banpot/LightCheck-KM/hardware/enclosure/README.md

# กล่องเครื่องวัดแสง LightCheck KM (ไฟล์พิมพ์ 3 มิติ)

LightCheck KM enclosure

กล่องสองชิ้น (ฐาน + ฝา) สำหรับ TSL2591 + Wemos D1 mini + LCD1602 I2C
ขนาดภายนอก **108 × 63 × 26 มม.** ใช้ถือวัดหรือตั้งบนขาตั้งกล้องที่ระดับระนาบวัด 75 ซม. ก็ได้

| ไฟล์ | รายละเอียด |
|---|---|
| `stl/lightcheck_base.stl` | ฐาน ชุดมาตรฐาน (วางพื้นกล่องลงฐานพิมพ์ จัดทิศไว้แล้ว) |
| `stl/lightcheck_lid.stl` | ฝา ชุดมาตรฐาน (คว่ำหน้าบนลงฐานพิมพ์ จัดทิศไว้แล้ว) |
| `stl/loose/lightcheck_base_loose.stl`, `stl/loose/lightcheck_lid_loose.stl` | ชุดหลวม สำหรับเครื่องพิมพ์ที่พิมพ์หยาบ (ดูหัวข้อถัดไป) |
| `stl/fit_test/hole_fit_test.stl` | แผ่นทดสอบรูสกรูและช่องนอต (~10 g) พิมพ์ก่อนเพื่อเลือกชุดที่พอดีกับเครื่อง |
| `src/lightcheck_enclosure.py` | สคริปต์สร้างแบบแบบ parametric (manifold3d) แก้ค่าแล้วรันใหม่ได้ |
| `stl/proxies/*.stl`, `stl/scene.json` | ชิ้นจำลองโมดูล ใช้ตรวจการชนและเรนเดอร์ภาพเท่านั้น (ไม่ต้องพิมพ์) |
| `render/` | ตัวเรนเดอร์ภาพ (three.js + Playwright) |
| `renders/*.png` | ภาพประกอบ (ประกอบแล้ว / แยกชิ้น / วางบนฐานพิมพ์) |

## แนวคิดการออกแบบ

- **หัววัดอยู่ระดับเดียวกับผิวฝา** บอร์ด TSL2591 ฝังในร่องบนผิวฝาด้านไกลจากผู้ใช้ ผิวบอร์ดเสมอผิวฝา ตัวเซนเซอร์โผล่สูงกว่าผิวฝา 0.65 มม.
  ส่วนของกล่องไม่มีอะไรสูงเกินระนาบเซนเซอร์ (หัวสกรูจมอยู่ในรูเคาน์เตอร์บอร์ ขอบ LCD ต่ำกว่าผิวฝา 0.3 มม.) เซนเซอร์จึงรับแสงได้เต็มครึ่งทรงกลมโดยไม่มีขอบกล่องบัง
- **ผู้ใช้ไม่บังแสง** LCD อยู่ฝั่งผู้ใช้ เซนเซอร์อยู่อีกฝั่ง และใช้ขาตั้งกล้องได้ (มีนอตหกเหลี่ยม 1/4"-20 ฝังใต้กล่อง ตรงใต้เซนเซอร์พอดี) จึงวัดที่ระนาบ 75 ซม. ได้โดยไม่มีเงาผู้วัด
- **ประกอบซ้ำง่าย** ไม่ต้องใช้ support ใช้สกรูทั่วไป และแก้ขนาดทุกค่าได้จากตัวแปรด้านบนของสคริปต์

## เลือกไฟล์ให้เหมาะกับเครื่องพิมพ์ (เผื่อความคลาดเคลื่อน)

เครื่องพิมพ์ FDM มักพิมพ์รูเล็กกว่าแบบราว 0.2–0.4 มม. และผนังหนากว่าแบบเล็กน้อย
รูนำสกรูที่ "พอดีเกิน" จึงขันยาก ไฟล์จึงมี 2 ชุดที่ต่างกันเฉพาะขนาดรูและระยะเผื่อ

| ชุด | ใช้กับ | ไฟล์ |
|---|---|---|
| **มาตรฐาน** | เครื่องที่ปรับตั้งดีแล้ว หัวฉีด 0.4 มม. ชั้น 0.2 มม. | `stl/lightcheck_base.stl` + `stl/lightcheck_lid.stl` |
| **หลวม (loose)** | เครื่องที่พิมพ์หยาบเล็กน้อย ชั้น 0.28 มม. หรือเนื้อพลาสติกล้น (over-extrusion) | `stl/loose/lightcheck_base_loose.stl` + `stl/loose/lightcheck_lid_loose.stl` |

**ฐานและฝาต้องมาจากชุดเดียวกัน** (ชุดหลวมยาวกว่า 1 มม. ทางด้านกว้าง)

| ขนาดในแบบ (มม.) | รุ่นแรก | มาตรฐาน | หลวม |
|---|---|---|---|
| รูนำสกรู M3 ในเสาฐาน | 2.5 | 2.8 | 3.0 |
| รูทะลุสกรู M3 ที่ฝา | 3.4 | 3.6 | 3.8 |
| รูเคาน์เตอร์บอร์หัวสกรู M3 | 6.4 | 6.6 | 6.8 |
| รูนำสกรู M2.5 (เสา LCD, รูบอร์ด TSL2591) | 2.1 | 2.3 | 2.5 |
| ช่องนอต 1/4"-20 (ปากกว้าง) | 11.46 | 11.66 | 11.86 |
| รูสกรูขาตั้งกล้อง | 6.8 | 7.0 | 7.2 |
| ระยะเผื่อขอบฝา และร่องบอร์ด TSL2591 (ต่อด้าน) | 0.30 | 0.35 | 0.55 |
| ระยะเผื่อช่องหน้าต่าง LCD (ต่อด้าน) | 0.40 | 0.45 | 0.65 |
| ลบมุมขอบล่างกัน elephant foot | 0.6 | 0.6 | 0.8 |
| ขนาดภายนอก | 108 × 63 × 26 | 108 × 63 × 26 | 108 × 64 × 26 |

ทุกรูนำสกรูมีปากผาย 45° ลึก 0.6 มม. ให้สกรูตั้งตรงและเริ่มกินเกลียวง่าย เสามุมขยายเป็น Ø7.6 มม.
เพื่อให้เนื้อพลาสติกรอบรูยังหนาพอ ระนาบเซนเซอร์ ตำแหน่งเซนเซอร์บนฝา และช่องรับแสงเหมือนเดิมทุกชุด

### ไม่แน่ใจว่าใช้ชุดไหน: พิมพ์แผ่นทดสอบก่อน

`stl/fit_test/hole_fit_test.stl` ใช้พลาสติกราว 10 กรัม มีเลขกำกับขนาดทุกรู (มม.)

- **รูนำ M3** 2.6 / 2.8 / 3.0 / 3.2 ในเสาสูง 6 มม. ขันสกรู M3 × 12 ด้วยไขควงมือ เลือกรูที่ขันได้โดยไม่ต้องออกแรงมากแต่สกรูไม่คลอน
  ได้ 2.8 ใช้ชุดมาตรฐาน ได้ 3.0 ใช้ชุดหลวม
- **รูนำ M2.5** 2.1 / 2.3 / 2.5 / 2.7 (2.3 = มาตรฐาน, 2.5 = หลวม)
- **ช่องนอต 1/4"** 11.46 / 11.66 / 11.86 เลือกช่องที่กดนอตลงด้วยนิ้วหรือเคาะเบา ๆ ได้
- ถ้าพอดีที่ 2.6 หรือ 3.2 ให้สร้างชุดของเครื่องตัวเอง โดย `--hole-comp` = ขนาดรู M3 ที่เลือก − 2.6

```bash
python3 src/lightcheck_enclosure.py --fit custom --hole-comp 0.6 --clr 0.6   # -> stl/custom/
```

### เคล็ดลับการขันสกรูลงพลาสติก

- ขันเข้าจนสุดแล้วคลายออกหนึ่งครั้งก่อนประกอบจริง เพื่อขึ้นเกลียวในพลาสติก
- ใช้ไขควงมือ ไม่ใช้สว่านไฟฟ้า (ความร้อนจากการหมุนเร็วทำให้ PLA ละลายและเกลียวรูด)
- ชิ้นรุ่นแรกที่พิมพ์ไปแล้วและรูคับ คว้านรูนำในเสาฐานด้วยดอกสว่าน 2.8 มม. (หมุนช้า ๆ) ก็ใช้ต่อได้

## การพิมพ์ (Print settings)

| รายการ | ค่าแนะนำ |
|---|---|
| วัสดุ | PLA หรือ PETG (PETG ทนความร้อนในรถ/ใกล้หน้าต่างกว่า) |
| Layer height | 0.2 มม. |
| Walls / perimeters | 3 |
| Top/bottom layers | 4–5 |
| Infill | 20% (gyroid/grid) |
| Support | **ไม่ต้องใช้** |
| ทิศการวาง | ฐาน: พื้นกล่องลงฐานพิมพ์ / ฝา: **คว่ำผิวบนลงฐานพิมพ์** (STL จัดทิศไว้แล้ว) |
| ปริมาตรเนื้อพลาสติก | ฐาน ~32 ซม.³, ฝา ~13 ซม.³ (รวมประมาณ 4–6 ชม. ที่ 0.2 มม. ขึ้นกับเครื่องพิมพ์) |

ส่วนที่เป็นสะพาน (bridge) มีแค่ เพดานร่องเซนเซอร์ (ช่วงสั้น 18.4 มม.) ช่อง USB (12.5 มม.) และบ่าเคาน์เตอร์บอร์ (6.4 มม.) ซึ่ง PLA/PETG ทั่วไปพิมพ์ได้
ขอบล่างของทั้งสองชิ้นลบมุม 0.6 มม. ไว้แล้ว เพื่อกลบ elephant foot

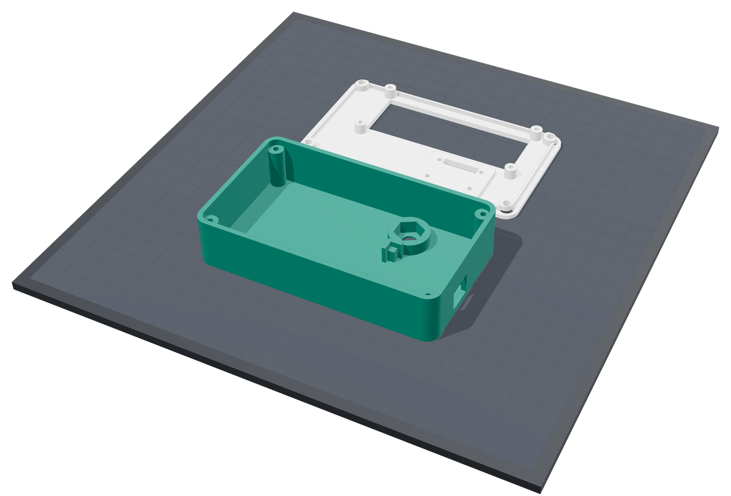
[picture p6: hardware/enclosure/renders/enclosure_printbed.png]
print bed


## อุปกรณ์ประกอบ (Hardware BOM)

| จำนวน | รายการ | ใช้ที่ |
|---|---|---|
| 4 | สกรู M3 × 12 มม. หัวกลม/หัวจม (self-tapping สำหรับพลาสติก) | ยึดฝากับฐาน (รูนำ Ø2.8 / Ø3.0 ในฐาน, รูเคาน์เตอร์บอร์ Ø6.6 / Ø6.8 ลึก 3 มม. ที่ฝา ตามชุดที่พิมพ์) |
| 4 | สกรู M2.5 × 6 มม. self-tapping | ยึด LCD1602 กับเสาใต้ฝา (รูนำ Ø2.3 / Ø2.5) |
| 1 | นอตหกเหลี่ยม 1/4"-20 UNC (ปากกว้าง 7/16" = 11.1 มม., หนา 7/32" = 5.6 มม.) | เกลียวขาตั้งกล้องใต้กล่อง |
| – | กาวร้อน / เทปกาวสองหน้าบาง | ยึด D1 mini กับแท่นรอง และยึด TSL2591 จากด้านใน |
| – | สายไฟ AWG 26–28 (บัดกรีตรง) | I2C: SDA, SCL, 3V3, 5V, GND |
| (เลือก) 4 | สกรู M2.5 × 4 มม. | ยึด TSL2591 จากด้านบน (หัวสกรูจะสูงกว่าระนาบเซนเซอร์ที่มุมบอร์ด ดูหมายเหตุ) |

## ขั้นตอนประกอบ

1. **D1 mini**: บัดกรีสายเข้าที่รู D1 (SCL), D2 (SDA), 3V3, 5V, G **จากด้านบนของบอร์ด** (ไม่ใส่ขา header ด้านล่าง) แล้ววางลงแท่นรองในฐาน ให้ขอบฝั่ง USB ชิดผนังขวา หยอดกาวร้อนเล็กน้อยที่มุม
2. **นอตขาตั้งกล้อง**: กดนอต 1/4"-20 ลงหลุมหกเหลี่ยมจากด้านในกล่อง (ด้านในเป็นบ่ารับ นอตจึงไม่หลุดเวลาขันขาตั้ง) จะหยอดกาวกันหมุนด้วยก็ได้
3. **LCD1602**: งอขา I2C 4 ขาของ backpack ลง 90° หรือบัดกรีสายตรง (ถ้าใช้ Dupont ตรง ต้องเพิ่ม `LCD_HEADER_CLEAR` เป็นประมาณ 25 มม.) ปรับ contrast ที่ trimpot ก่อนปิดฝา แล้วยึด LCD กับเสา 4 ต้นใต้ฝาด้วย M2.5 ให้กรอบโลหะสอดผ่านช่องหน้าต่าง
4. **TSL2591**: สอดสาย/ขา header ลงช่องใต้ร่อง วางบอร์ดลงร่องให้ผิวบอร์ดเสมอผิวฝา แล้วยึดจากด้านในด้วยกาวร้อนหรือเทป
   *แนะนำ:* ตัด jumper LED ของ Adafruit (ไฟเขียวบนบอร์ด) เพื่อไม่ให้มีแสงรบกวนตอนวัดแสงน้อย
5. ต่อสายตามผังวงจรใน `docs/wiring.md` แล้วทดสอบเปิดเครื่อง (ต้องขึ้น "All systems GO") **ก่อน**ปิดฝา
6. ปิดฝาโดยให้ขอบ lip ลงในผนังฐาน แล้วขันสกรู M3 × 12 ทั้ง 4 มุม (ไม่ต้องแน่นมาก ไม่งั้นเกลียวในพลาสติกจะรูด)

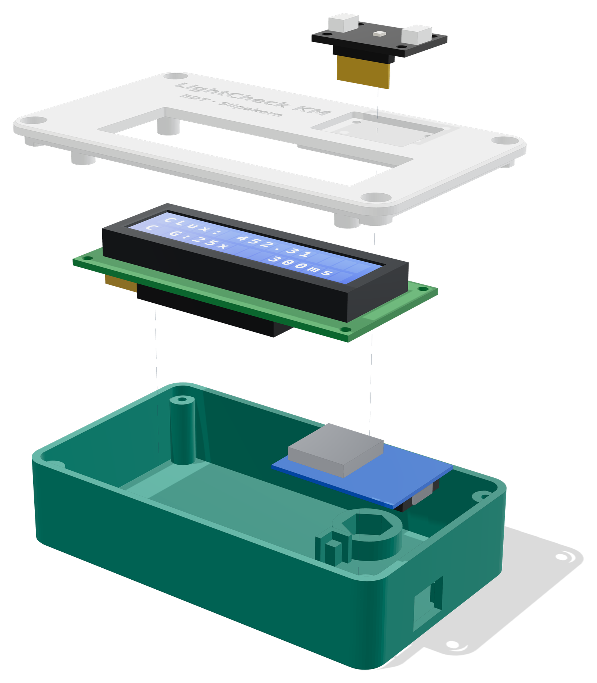
[picture p7: hardware/enclosure/renders/enclosure_exploded.png]
exploded


## ขนาดที่ต้องวัดจากโมดูลจริงก่อนพิมพ์ ([VERIFY])

ทุกค่าอยู่ในหัวไฟล์ `src/lightcheck_enclosure.py` โมดูลจากต่างร้านมีขนาดต่างกันได้

| ตัวแปร | ค่าที่ใช้ | ที่มา / หมายเหตุ |
|---|---|---|
| `TSL_W × TSL_D` | 25.4 × 17.78 มม. | จากไฟล์ EAGLE ของ Adafruit (#1980 รุ่น STEMMA QT); รุ่นเก่าที่ไม่มี STEMMA เล็กกว่า (~19 × 16 มม.) |
| `TSL_HOLE_DX/DY`, `TSL_HDR_Y` | 20.32 / 12.70 / −6.35 มม. | จากไฟล์ EAGLE ของ Adafruit (รู Ø2.5 ที่มุม, header 6 ขาตามขอบยาว, เซนเซอร์อยู่กลางบอร์ด) |
| `TSL_T` | 1.6 มม. | ความหนา PCB ซึ่งกำหนดความลึกร่องให้ผิวบอร์ดเสมอฝา |
| `LCD_BEZEL_H` | 7.0 มม. | ความสูงกรอบโลหะจากผิว PCB (ทั่วไป 6.5–9.5) ค่านี้กำหนดความยาวเสา LCD |
| `LCD_BEZEL_W × D`, offset | 71.2 × 24.2 มม., (0,0) | ขนาดกรอบโลหะและระยะเยื้องจากศูนย์กลาง PCB |
| `LCD_HOLE_DX/DY` | 75 × 31 มม. | ระยะรูยึด LCD |
| `LCD_BACK_DEPTH` | 12 มม. | ความลึกของ backpack + trimpot ใต้ PCB ของ LCD |
| `D1_L × D1_W`, `D1_T` | 34.2 × 25.6, 1.0 มม. | ขนาด D1 mini (v3/v4); ช่อง USB 12.5 × 9.5 มม. ใช้ได้ทั้ง micro-USB และ USB-C ไม่ว่าคอนเนกเตอร์จะอยู่ด้านบนหรือล่างของบอร์ด |
| `NUT_AF`, `NUT_T` | 11.46 + ค่าเผื่อรู / 5.56 มม. | นอต 1/4"-20 ที่ซื้อจริง |
| `FIT_PROFILES` | มาตรฐาน: รู +0.2, เผื่อ 0.35 / หลวม: รู +0.4, เผื่อ 0.55 | ค่าเผื่อของเครื่องพิมพ์ ปรับเองได้ด้วย `--fit custom --hole-comp X --clr Y` |

ผลตรวจล่าสุดของสคริปต์: ทั้งสองชิ้นปิดสนิท (watertight) ไม่มีส่วนใดชนกับชิ้นจำลองโมดูล
ช่องว่าง backpack ถึงพื้น 3.1 มม., ช่องว่าง D1 shield ถึง PCB ของ LCD 5.2 มม., ผิวบอร์ด TSL2591 = ผิวฝา = 26.0 มม., ยอดเซนเซอร์ 26.65 มม.

## ⚠️ ข้อกำหนดด้านคุณภาพการวัด

ตาม KM ข้อ 9.1.12 **ถ้าเปลี่ยนกล่อง ฝา ร่อง/ช่องรับแสง แผ่น diffuser หรือตำแหน่งเซนเซอร์ ต้องทวนสอบ (verification) กับเครื่องอ้างอิงใหม่ และพิจารณาสร้างค่า coefficient ใหม่**
ต้องบันทึกเวอร์ชันกล่องที่ใช้ (ชื่อไฟล์ STL และ commit) ไว้คู่กับ `CAL_MODEL_VERSION` ในรายงาน calibration ด้วย
ชุดมาตรฐาน/หลวมต่างกันเฉพาะรูสกรูและระยะเผื่อ ระนาบและตำแหน่งเซนเซอร์บนฝาเหมือนกัน แต่ให้ระบุชุดที่ใช้ในรายงานด้วย

หมายเหตุ: ขั้วต่อ STEMMA QT สีขาวบนบอร์ด Adafruit สูงกว่าเซนเซอร์ประมาณ 2.3 มม. ที่ระยะ ±10 มม.
จึงบังแสงเฉพาะมุมตกกระทบที่เกิน ~76° ซึ่งมีน้ำหนักตาม cosine น้อยมาก ถ้าใช้สกรูยึดบอร์ดจากด้านบนก็มีผลแบบเดียวกัน
ทั้งหมดนี้รวมอยู่ใน calibration แล้ว **ถ้าเปลี่ยนวิธียึดหรือตัดขั้วต่อออก ให้ทวนสอบใหม่**

## สร้างไฟล์ใหม่ (Regenerate)

```bash
pip install manifold3d trimesh numpy matplotlib
python3 src/lightcheck_enclosure.py        # สร้าง STL ทั้งชุดมาตรฐาน ชุดหลวม และแผ่นทดสอบ + ตรวจ watertight / ระยะชน / ระนาบเซนเซอร์ แล้วแสดง PASS
# render (ไม่บังคับ)
cd render && npm i && cd .. && python3 -m http.server 8765 &
node render/render.mjs hero exploded print
```

---

### English summary

Two-part, support-free enclosure (108 × 63 × 26 mm) for TSL2591 + Wemos D1 mini + LCD1602/I2C.
The TSL2591 board sits flush in a pocket on the top face at the far end, so nothing of the enclosure rises above the sensor plane
(screw heads are counterbored and the LCD bezel sits 0.3 mm below the top). A captured 1/4"-20 nut under the sensor allows
tripod mounting at the 75 cm measurement plane. Print in PLA/PETG at 0.2 mm, 3 walls, 20 % infill, no supports: base floor-down, lid top-face-down
(STLs are pre-oriented). Two fit profiles: `stl/` (standard, holes +0.2 mm, 0.35 mm clearance) and `stl/loose/` (coarse printers,
holes +0.4 mm, 0.55 mm clearance); print `stl/fit_test/hole_fit_test.stl` (~10 g) to choose, or build your own with
`--fit custom --hole-comp X --clr Y`. Hardware: 4× M3×12 self-tapping, 4× M2.5×6 self-tapping, 1× 1/4"-20 hex nut. All `[VERIFY]` dimensions are named
parameters in `src/lightcheck_enclosure.py`. Any change to the enclosure, aperture or sensor position requires re-verifying the calibration (KM §9.1.12).
