banpot/LightCheck-KM/docs/references.md

# เอกสารอ้างอิง

ตรวจสอบการเข้าถึงลิงก์ ณ วันที่ 10 สิงหาคม 2569 (และ 23 ตุลาคม 2569 สำหรับ [4][5][7])

1. กรมการเปลี่ยนแปลงสภาพภูมิอากาศและสิ่งแวดล้อม. (2569). *เกณฑ์การประเมินสำนักงานสีเขียว (Green Office) ปี 2569*. https://www.dcce.go.th/15765/
2. กรมสวัสดิการและคุ้มครองแรงงาน. (2561). *ประกาศเรื่อง มาตรฐานความเข้มของแสงสว่าง (ตารางมาตรฐานแนบท้ายประกาศ)*. https://osh.labour.go.th/wp-content/uploads/2026/02/lighting-std-2561.pdf
3. กรมสวัสดิการและคุ้มครองแรงงาน. (2561). *หลักเกณฑ์ วิธีการตรวจวัด และการวิเคราะห์สภาวะการทำงานเกี่ยวกับระดับความร้อน แสงสว่าง หรือเสียง*. https://osh.labour.go.th/wp-content/uploads/2026/02/11.pdf
4. Adafruit Industries. *Adafruit TSL2591 High Dynamic Range Digital Light Sensor*. https://learn.adafruit.com/adafruit-tsl2591/overview
5. ams. (2018). *TSL2591 Light-to-Digital Converter Datasheet* DS000338 v2-04 (6-00). https://cdn-learn.adafruit.com/assets/assets/000/078/658/original/TSL2591_DS000338_6-00.pdf
6. Lorenzo, O. G., Suárez-García, A., Peña, D. G., Fuente, M. G., & Granados-López, D. (2022). A Low-Cost Luxometer Benchmark for Solar Illuminance Measurement System Based on the Internet of Things. *Sensors, 22*(19), 7107. https://doi.org/10.3390/s22197107
7. HIOKI. *LUX METER FT3424 – specifications* (linearity ±2 % rdg., JIS C 1609-1:2006 general AA, DIN 5032-7 class B). https://www.hioki.com/th-th/products/field-measuring/light-lux/id_5892
8. DigiKey Thailand. *Adafruit Industries 1980 (TSL2591 breakout)*. https://www.digikey.co.th/th/products/detail/adafruit-industries-llc/1980/4990786
9. Shopee Thailand. *Wemos D1 mini ESP8266* (ตัวอย่างราคาออนไลน์)
10. ArduinoAll / AllNewStep. *LCD1602 พร้อม I2C Interface 5V* (ตัวอย่างราคาออนไลน์)
11. Thai Interelectric. *HIOKI FT3424* (ตัวอย่างราคาในประเทศไทย). https://shop.thai-interelectric.co.th/shop/ft3424/
12. Adafruit. *Adafruit_TSL2591_Library* v1.4.5 (calculateLux, LUX_DF = 408). https://github.com/adafruit/Adafruit_TSL2591_Library
