banpot/LightCheck-KM/poster/LightCheck-KM_poster_80x100_editable.pptx

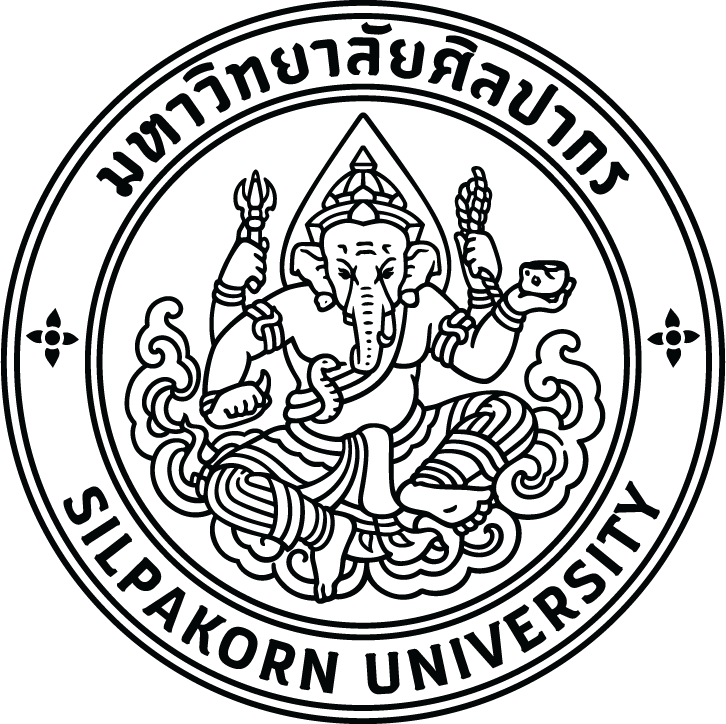
[picture p8: figure]

LightCheck KM

จากเครื่องวัดแสงต้นทุนต่ำ สู่ระบบความรู้
เพื่อยกระดับสภาพแวดล้อมสำนักงานสีเขียว

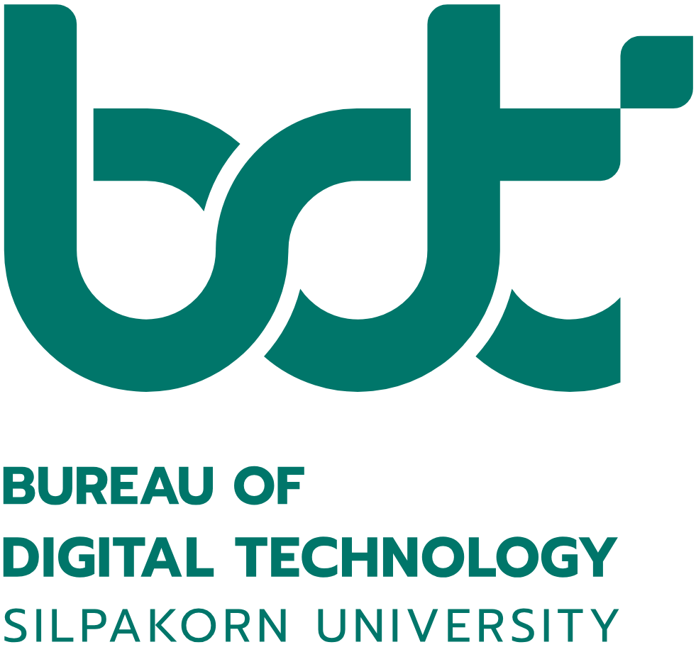
[picture p9: figure]
ภาพ bdt_logo_stacked.svg

KM · ด้านการบริหารจัดการและสร้างนวัตกรรม

INTRODUCTION

ที่มาและความสำคัญ

ว่าที่ ร.ต. ดร. บรรพต ดลวิทยากุล

ฝ่ายบริหารและพัฒนาดิจิทัลเทคโนโลยี สำนักดิจิทัลเทคโนโลยี มหาวิทยาลัยศิลปากร

METHODS

แนวคิดและกระบวนการดำเนินงาน

RESULTS

ผลลัพธ์จากการจัดการความรู้

“รู้สึกว่าพอ” อาจไม่พอ
สำหรับสายตาคนทำงานทั้งวัน

สายตาปรับตัวกับแสงสลัวจนเราไม่ทันสังเกต แต่ต้องเพ่งอยู่ตลอดวัน ผลเสียจึงสะสมกับคนทำงาน [8, 9]

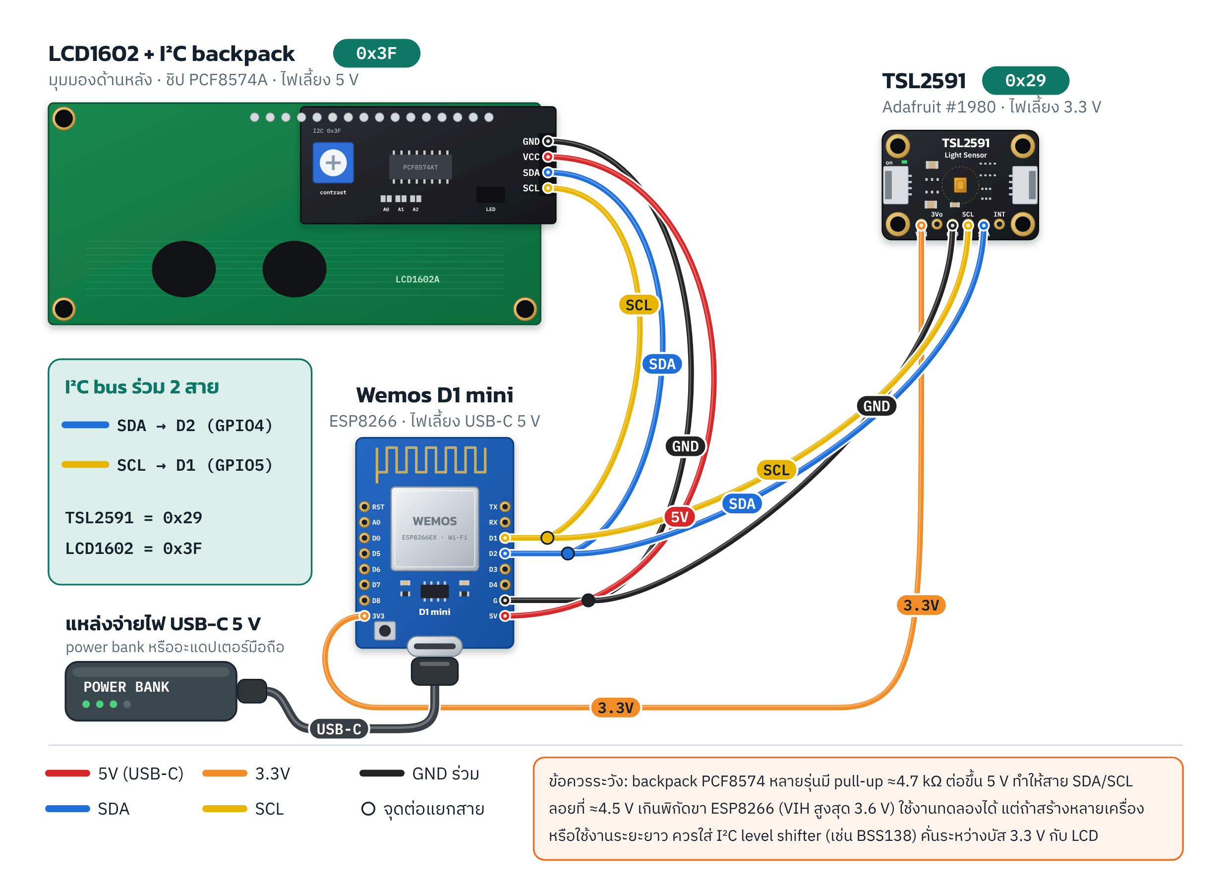
[picture p10: figure]
ภาพ wiring_diagram.svg

ภาพที่ 2 ผังวงจร: I²C ร่วม 2 สาย (SDA = D2, SCL = D1) · TSL2591 0x29 · LCD 0x3F · ไฟเลี้ยง USB-C 5 V จาก power bank

ยังไม่มีข้อมูลวัดคู่จริง จึงประเมินด้วยวิธีเชิงอัลกอริทึม: Monte Carlo 5,000 รอบ จาก datasheet TSL2591 + สเปก Hioki FT3424 (±2% rdg.) ผลจำลอง

±7.3%

ความคลาดเคลื่อน (95%) หลังชดเชย เทียบกับค่าจริง

37% → 2.5%

MAPE ก่อน → หลังชดเชย (P95 หลังชดเชย 4.0%)

ตัวชี้วัดจึงมีที่มา: Green Office 2569 ข้อ 5.2.1 ให้วัดเป็นตัวเลขทุกปีด้วยเครื่องที่สอบเทียบ ห้ามใช้แอปมือถือ [1] แต่เครื่องมาตรฐานที่ถูกสุด (HIOKI FT3424) ราคา 28,184 ฿ จึงมีได้ไม่กี่เครื่อง

เกณฑ์ขั้นต่ำเพื่อสายตาคนทำงาน [2] · วัดที่ระนาบ 75 ซม. ทุกช่อง 2×2 ม. และ ณ จุดทำงาน ในสภาพทำงานปกติ ช่วงแสงธรรมชาติน้อยที่สุด [3]

300 lx

ค่าเฉลี่ย
พื้นที่สำนักงาน

ตาล้า
ปวดตา

150 lx

จุดต่ำสุด
ของพื้นที่

ปวดศีรษะ
ไมเกรน

400–500

lux ณ จุดทำงาน
(งานเขียน พิมพ์ อ่าน)

ซึม
สมาธิลด

เสี่ยง
อุบัติเหตุ

45% → 0.07%

ตัดสินผ่าน/ไม่ผ่านผิดที่เกณฑ์ 300 lx (guard band: ส่งยืนยัน 13% ของจุด)

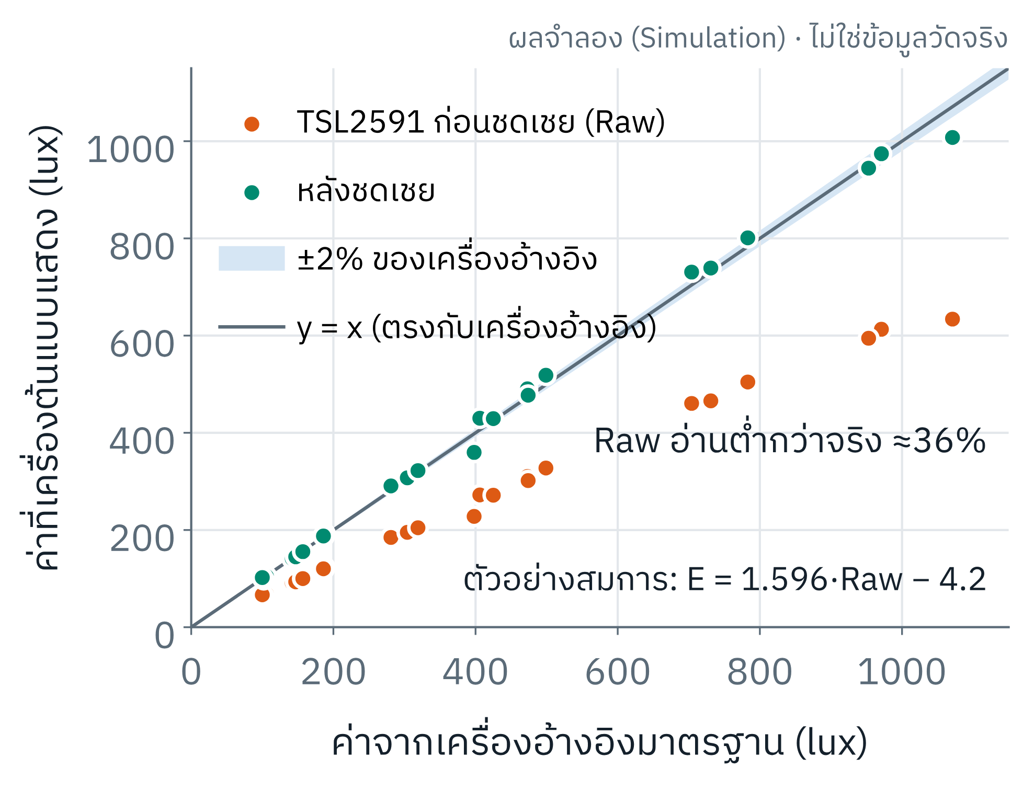
[picture p11: figure]
ภาพ fig_cal_scatter_poster.svg

ภาพที่ 6 ต้นแบบเทียบเครื่องอ้างอิง: ก่อนชดเชยอ่านต่ำกว่าจริงราว 1/3 (ประมาณจาก datasheet) หลังชดเชยเข้าใกล้ y = x

41 → 0

ระดับแสงที่ auto-range แกว่งจน SATURATED (v1.0 → v1.1, 521 ระดับ)

วัตถุประสงค์

ให้คนทำงานได้แสงที่เหมาะกับงานจริง ด้วยเครื่องคัดกรอง (pre‑survey) ต้นทุนต่ำที่ตรวจสอบย้อนกลับได้

กล่องพิมพ์ 3 มิติ (ไฟล์ STL เปิดให้ดาวน์โหลด)

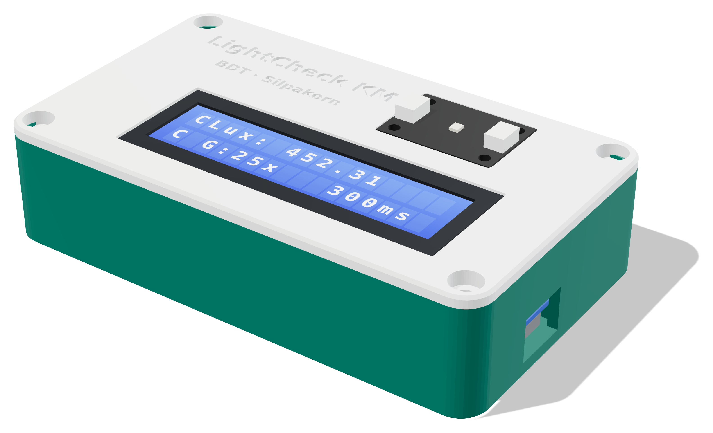
[picture p12: figure]

ภาพที่ 3 Render จากไฟล์ STL · 108×63×26 มม. · หัวรับแสงเสมอผิวฝา ไม่มีขอบบังแสง · ช่องนอต 1/4" ใต้กล่องสำหรับขาตั้งกล้องที่ระดับ 75 ซม.

1

2

3

เปลี่ยนความรู้ที่อยู่กับผู้พัฒนา ให้เป็นความรู้ขององค์กร: โค้ด SOP คู่มือ ไฟล์ STL ในคลังสาธารณะ

ปรับปรุงแสงด้วยข้อมูลเชิงประจักษ์ตามวงจร PDCA (ตรวจ → แก้ → ตรวจซ้ำ) ของ Green Office 5.2.1

วงจรการจัดการความรู้ (PDCA + KM)

ห้องทำงานเกือบทุกห้องของสำนักดิจิทัลเทคโนโลยี (ยกเว้นห้องประชุม) มีแสงต่ำกว่าระดับมาตรฐาน → ผู้บริหารวางแผนปรับปรุง

เช่น วัดได้ 270 lx: 18 W → 22 W

เช่น วัดได้ 220 lx, 6 ดวง → 9 ดวง

Lumen method: E = NΦ·UF·MF/A ⇒ E ∝ NΦ · เป้าหมาย = เกณฑ์ × (1 + U95) · ยืนยันด้วยเครื่องมาตรฐานก่อนจัดซื้อ

ผลการใช้งานจริง

10–30%

ขาดเล็กน้อย
เปลี่ยนหลอด LED
วัตต์สูงขึ้น

ขาดมาก
ติดหลอดไฟเพิ่ม

1

6

วางแผน

P · เกณฑ์ + จุดวัด

ใช้ซ้ำ

KM · public repo

LightCheck KM

PDCA + Tacit → Explicit

2

5

ตรวจวัด

D · pre-survey

ถอดบทเรียน

KM · บทเรียน

3

4

ตรวจสอบ

C · ยืนยันผล

ปรับปรุง

A · แก้ + ตรวจซ้ำ

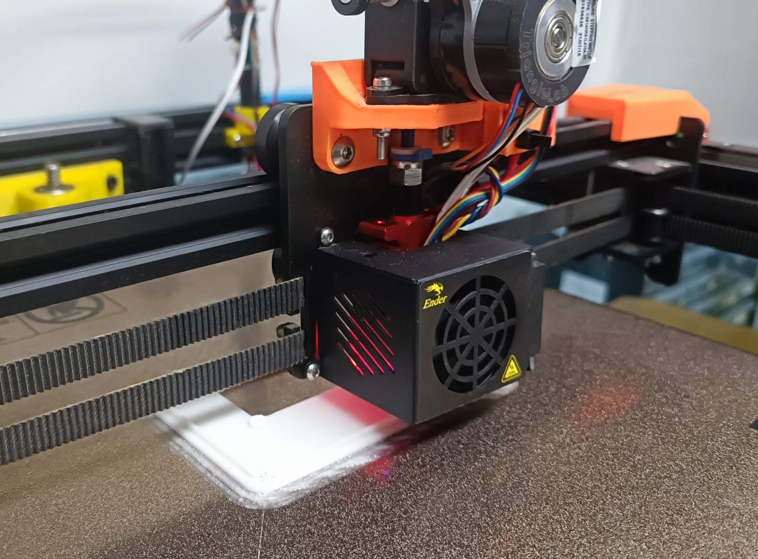
[picture p13: figure]
ภาพที่ 4 พิมพ์กล่อง Ender-6

ภาพที่ 4 พิมพ์ด้วย Creality Ender-6

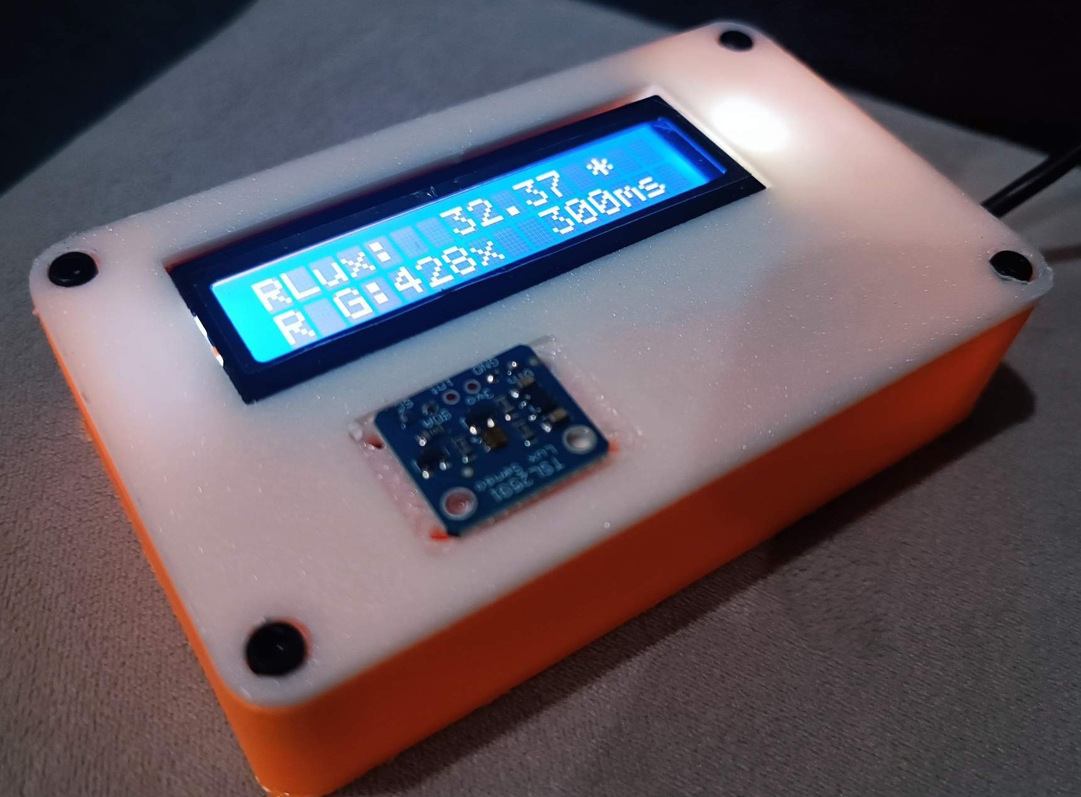
[picture p14: figure]
ภาพที่ 5 เครื่องที่ประกอบเสร็จ

ภาพที่ 5 เครื่องที่ประกอบเสร็จ พร้อมใช้

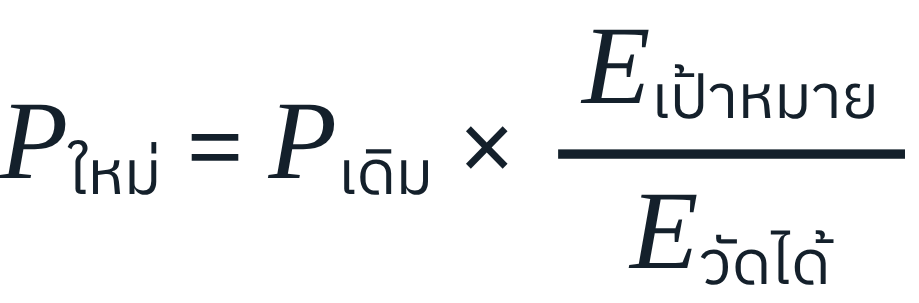
[picture p15: figure]
สูตรเปลี่ยนวัตต์หลอด
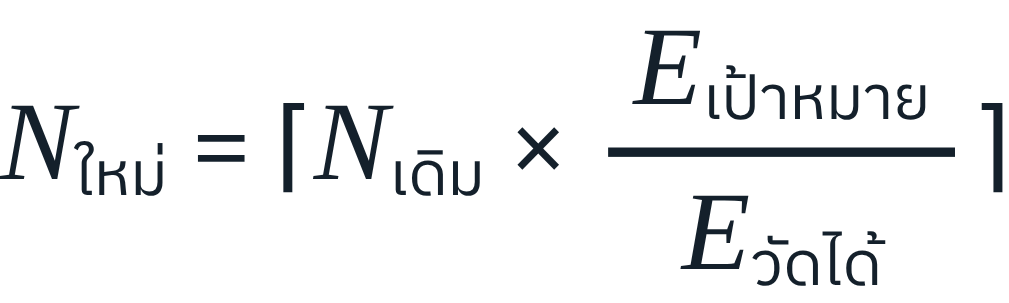
[picture p16: figure]
สูตรเพิ่มจำนวนหลอด

ภาพที่ 1 PDCA ของการดูแลแสง + ชั้น KM ทำให้ทุกรอบกลายเป็นความรู้ขององค์กร

อุปกรณ์และต้นทุน

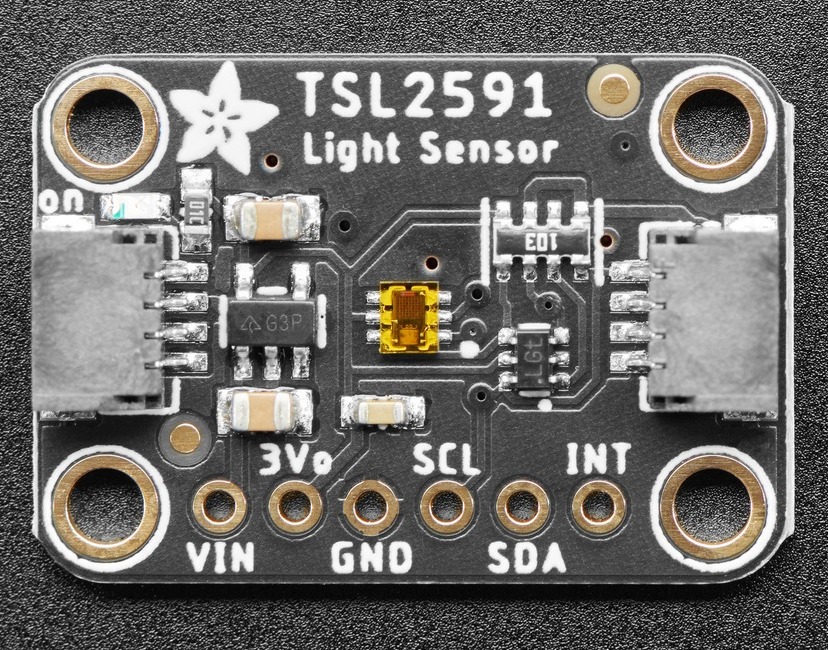
[picture p17: figure]
รูป TSL2591
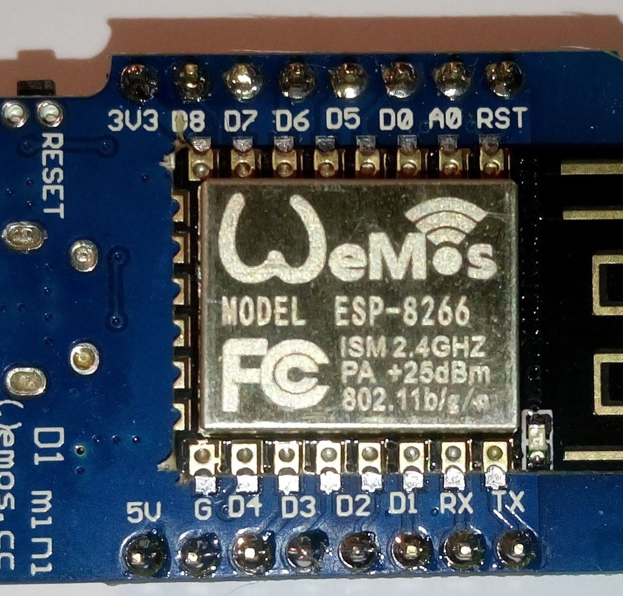
[picture p18: figure]
รูป Wemos D1 mini
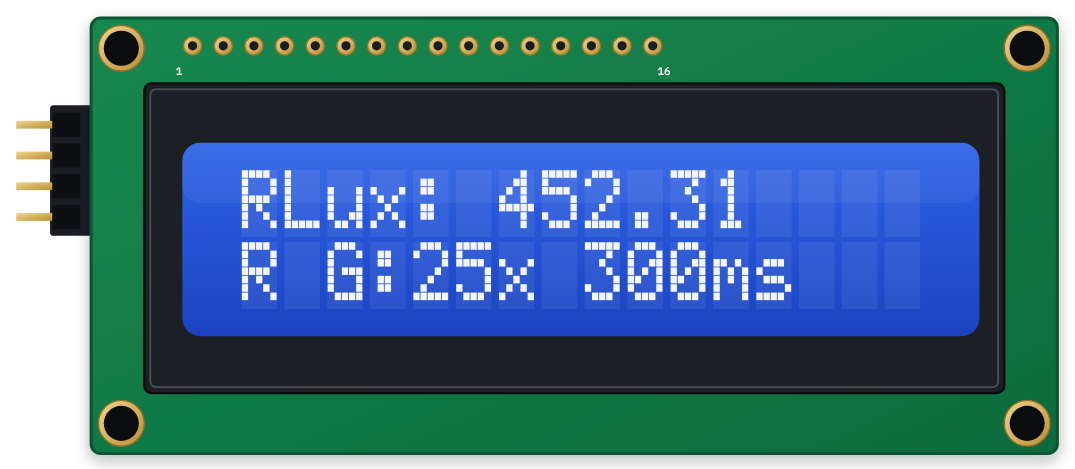
[picture p19: figure]
ภาพ component_lcd1602_front.svg

อัลกอริทึมใน firmware v1.1

Self-check I²C ก่อนวัด ป้องกันการบันทึกค่าจากระบบที่ต่อผิด

1

2

3

ตรวจ saturation ตาม datasheet (36,863 / 65,535 counts)

Auto-range มี hysteresis: 100–2,900 lx อ่านที่ gain 25× เสมอ

CONCLUSIONS

สรุปและบทเรียน

TSL2591

หัวรับแสง · 200 ฿

LightCheck KM
ต้นทุนจริง

HIOKI FT3424
ถูกที่สุดที่สำรวจได้

~73×

ภาพ: Adafruit Industries (CC BY-SA) · Tpkull / Wikimedia Commons (CC BY-SA 4.0)

≈ 385 ฿ (89 + 200 + 70 + PLA+ 54 g ≈ 26)

HIOKI FT3424 (ญี่ปุ่น, JIS C 1609-1 AA / DIN 5032-7 B) 26,340 ฿ + VAT 7% = 28,183.80 ฿ [7]

Wemos D1 mini

ESP8266 · 89 ฿

LCD1602 + I²C

จอแสดงผล · 70 ฿

28,184 ฿

4

5

บทเรียนหน้างาน: LED สว่างตามขนาดกระแส วูบ 100 ครั้ง/วินาทีจากไฟ 50 Hz [10] → integration 300 ms (30 รอบพอดี) + เฉลี่ย 5 ค่า

สมการชดเชยความคลาดเคลื่อน

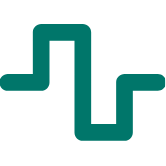
[picture p20: figure]
ภาพ #5

เฉลี่ย 5 รอบ ลดผล LED กะพริบ · จอแสดง * เมื่อค่านิ่ง (CV < 2%)

ชดเชย + traceability: บันทึก Raw/Corrected, gain และรุ่นสมการ

1.

2.

3.

เปิดให้ร่วมพัฒนาต่อบน GitHub

· วัดคู่จริงกับเครื่องมาตรฐาน

ใช้ได้จริง: เครื่องละ ~385 ฿ พบห้องแสงไม่พอ → แผนปรับปรุงทันที

บทเรียนหน้างาน: LED วูบ 100 ครั้ง/วินาทีตามไฟ 50 Hz → เฉลี่ย 5 ค่า ค่านิ่งขึ้น ~2.3 เท่า

ความรู้เป็นโค้ด SOP คู่มือ STL ที่ทำซ้ำได้โดยไม่ต้องพึ่งผู้พัฒนา

· สมการแยกตามชนิดหลอด

ถูกกว่า แต่ไม่ได้เทียบเท่า: ต้นแบบหลายเครื่อง = คัดกรองให้ทั่ว · เครื่องมาตรฐาน = ยืนยันผลทางการ

ใครใช้ประโยชน์ได้อย่างไร

คณะ / ส่วนงาน

เจ้าหน้าที่เทคนิค / นักวิจัย

ADC
CH0, CH1

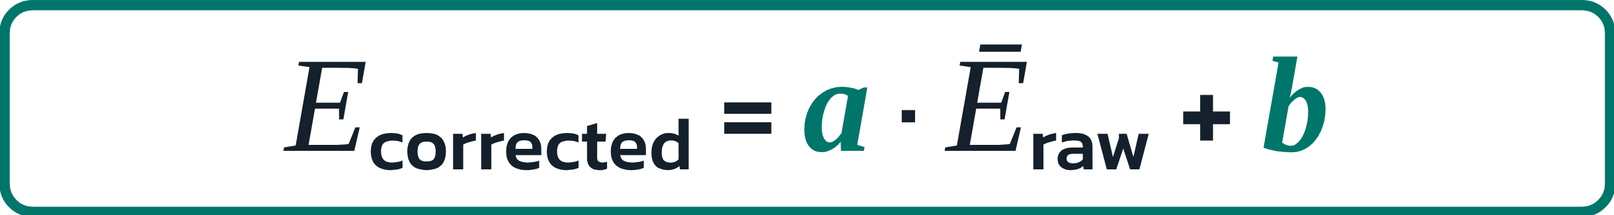
[picture p21: figure]
สมการชดเชย (หลัก)
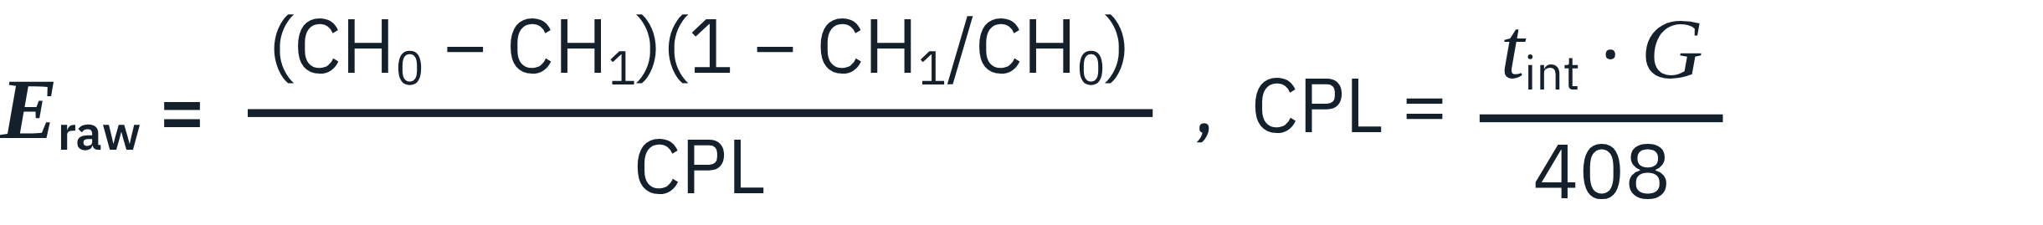
[picture p22: figure]
สมการ Raw lux และ CPL

→

Raw Lux
Eraw

→

เฉลี่ย 5 ค่า
Ēraw

→

ค่าหลังชดเชย
Ecorr

เผยแพร่แล้ว · สแกนเพื่อนำไปใช้

github.com/banpot/LightCheck-KM

· Wi-Fi logging + dashboard

· แผนที่ความสว่างจากกริด

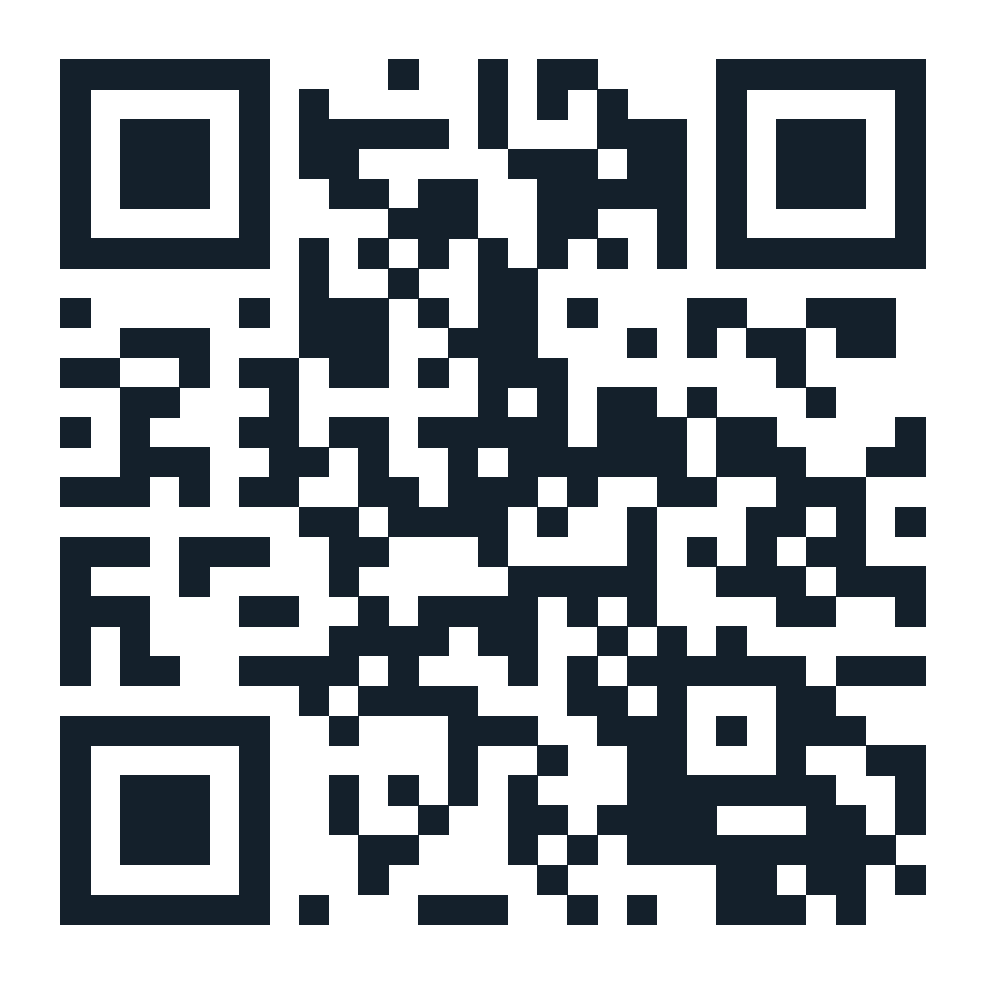
[picture p23: figure]
QR GitHub

1

2

สแกน QR → คู่มือ, firmware, STL

ซื้ออุปกรณ์ 359 ฿ + พิมพ์กล่อง 54 g

· ฝากระจายแสง (cosine)

· เซนเซอร์ CO₂/อุณหภูมิ/เสียง

REFERENCES

1. ทส. (2569). เกณฑ์ Green Office ปี 2569

2. กสร. (2561). มาตรฐานความเข้มแสงสว่าง

3. กสร. (2561). หลักเกณฑ์การตรวจวัดแสง

4. Adafruit. TSL2591 sensor guide

ไม่ต้องมีพื้นฐาน: ยืมเครื่อง → จดค่าเมื่อจอขึ้น * → ส่งจุดเสี่ยงยืนยัน

6. Lorenzo et al. (2022). Sensors 22(19), 7107

7. HIOKI. FT3424 Lux meter specifications

8. HSE (1997). Lighting at work, HSG38

9. CCOHS (2025). Lighting Ergonomics

ต่อยอด: Wi-Fi + dashboard, เชื่อม SU Green Office, เพิ่ม CO₂/อุณหภูมิ/เสียง

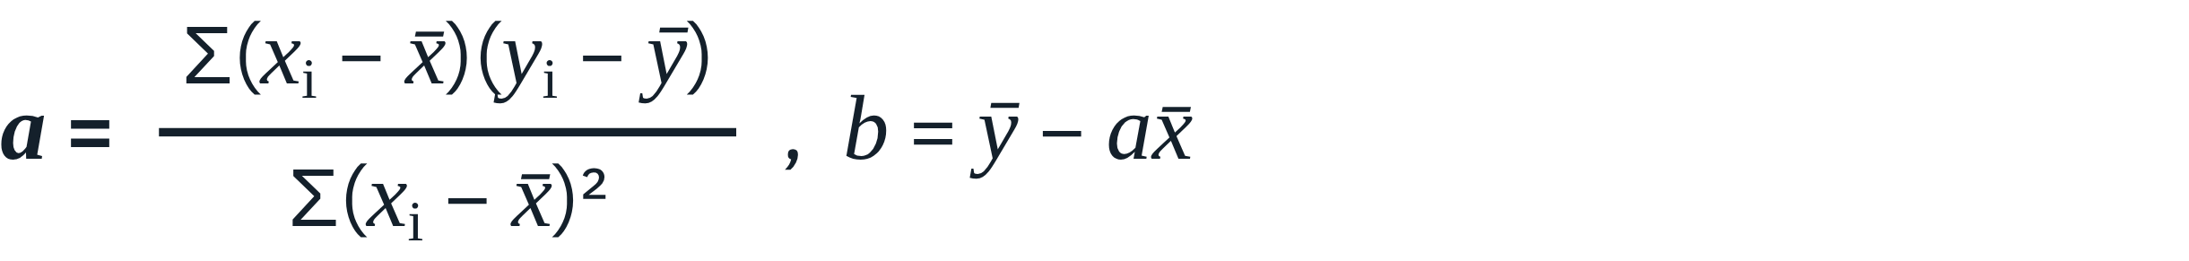
[picture p24: figure]
สมการ a และ b (least squares)

x = Raw ของต้นแบบ, y = ค่าเครื่องอ้างอิงที่มีใบสอบเทียบ (fit ด้วย least squares, ทดสอบบนชุด validation) · tint = 300 ms · G = 25

ตัวอย่างผลจำลอง a = 1.596, b = −4.2 lx: Raw 250 lx ⇒ Ecorr = 1.596×250 − 4.2 = 394.8 lx อยู่ในช่วงยืนยันของเกณฑ์ 400 lx (371–429 lx) → วัดซ้ำด้วยเครื่องมาตรฐาน

20

เอกสาร/คู่มือ

5

ไฟล์ STL

3

4

5

6

20

เครื่องมือ Python

ต่อสายตามผัง + อัปโหลด firmware

สอบเทียบกับเครื่องมาตรฐาน 1 ครั้ง

วัดตาม SOP: จดค่าเมื่อจอขึ้น * จุดใกล้เกณฑ์ส่งยืนยัน

ขอรับการถ่ายทอด: เปิด Issue ใน repo

Public

MIT / CC BY 4.0

5. ams (2018). TSL2591 datasheet

Silpakorn KM Day 2569

18 Dec 2026

10. DOE/PNNL (2016). Photometric Flicker

ตัวเลขที่ติดป้าย ผลจำลอง มาจากแบบจำลองเชิงอัลกอริทึม ไม่ใช่ข้อมูลวัดจริง
สร้างซ้ำได้ด้วยคำสั่ง make all ใน repository

OFFICE THE PRESIDENT SILPAKORN UNIVERSITY

22, Borommarachachonani Rd., Talingchan, Bangkok

Notes: ไฟล์ต้นฉบับโปสเตอร์ LightCheck KM (Silpakorn KM Day 2569) ขนาด 80 × 100 ซม.

ก่อนแก้ไข: ติดตั้งฟอนต์ Kanit และ IBM Plex Sans Thai ทุกไฟล์ในโฟลเดอร์ fonts (คลิกขวา > Install for all users) แล้วเปิดไฟล์นี้ใหม่
ถ้าไม่ติดตั้ง PowerPoint จะใช้ฟอนต์อื่นแทนและข้อความอาจล้นกรอบ

ใส่/เปลี่ยนรูป: คลิกขวาที่รูป > Change Picture > From a File (เช่น "ภาพที่ 5 ..." กรอบประ) แล้วใช้ Crop > Fill ถ้าสัดส่วนไม่ตรง
แก้ข้อความ: คลิกที่ข้อความแล้วพิมพ์ทับได้เลย ทุกกล่องเป็น text box จริง (ดูชื่อวัตถุทั้งหมดที่ Home > Arrange > Selection Pane)
ส่วนที่เป็นรูปภาพ: ผังวงจร กราฟ กล่องพิมพ์ 3 มิติ โลโก้ QR และสมการ (แก้สมการที่ poster/build_poster.py ใน repository)

ส่งออก PDF: File > Export > Create PDF/XPS > Options: เลือกเฉพาะสไลด์นี้, Optimize for: Standard
ถ้าต้องส่งเป็น CMYK: python poster/pdf_to_cmyk.py โปสเตอร์.pdf โปสเตอร์_CMYK.pdf 200 (ดู poster/README.md)
ส่งให้เพื่อนแก้ต่อ: File > Options > Save > Embed fonts in the file (ฟอนต์ทั้งสองเป็น OFL ฝังได้)
