banpot/LightCheck-KM/poster/LightCheck-KM_poster_RGB.pdf

# LightCheck KM

# จากเครื่องวัดแสงต้นทุนต่ำ สู่ระบบความรู้ เพื่อยกระดับสภาพแวดล้อมสำ นักงานสีเขียว

# ว่าที่ ร.ต. ดร. บรรพต ดลวิทยากุล

ฝ่ายบริหารและพัฒนาดิจิทัลเทคโนโลยี สำ นักดิจิทัลเทคโนโลยี มหาวิทยาลัยศิลปากร | KM · ด้านการบริหารจัดการและสร้างนวัตกรรม

# INTRODUCTION

## ที่มาและความสำ คัญ

# “รู้สึกว่าพอ” อาจไม่พอ สำ หรับสายตาคนทำ งานทั้งวัน

## สายตาปรับตัวกับแสงสลัวจนเราไม่ทันสังเกต แต่ต้องเพ่งอยู่ตลอด วัน ผลเสียจึงสะสมกับคนทำ งาน [8, 9]

ตาล้า
ปวดตา

ปวดศีรษะ
ไมเกรน

ซึม
สมาธิลด

เสี่ยง

อุบัติเหตุ

## ตัวชี้วัดจึงมีที่มา: Green Office 2569 ข้อ 5.2.1 ให้วัดเป็นตัวเลขทุก ปีด้วยเครื่องที่สอบเทียบ ห้ามใช้แอปมือถือ [1] แต่เครื่องมาตรฐานที่ ถูกสุด (HIOKI FT3424) ราคา 28,184 ฿ จึงมีได้ไม่กี่เครื่อง

300lx

ค่าเฉลี่ย

พื้นที่สำ นักงาน

150lx

จุดต่ำ สุด

ของพื้นที่

400–500

lux ณ จุดทำ งาน
(งานเขียน พิมพ์ อ่าน)
เกณฑ์ขั้นต่ำ เพื่อสายตาคนทำ งาน [2] · วัดที่ระนาบ 75 ซม. ทุกช่อง 2×2 ม. และ ณ จุด ทำ งาน ในสภาพทำ งานปกติ ช่วงแสงธรรมชาติน้อยที่สุด [3]

## วัตถุประสงค์

## วงจรการจัดการความรู้ (PDCA + KM)

1

## วางแผน

P · เกณฑ์ + จุดวัด

2

## ตรวจวัด

D · pre-survey

3

## ตรวจสอบ

C · ยืนยันผล

4

## ปรับปรุง

A · แก้ + ตรวจซ้ำ

5

## ถอดบทเรียน

KM · บทเรียน

6
ใช้ซ้ำ
KM · public repo

# LightCheck KM

### PDCA + Tacit → Explicit

ภาพที่ 1 PDCA ของการดูแลแสง + ชั้น KM ทำ ให้ทุกรอบกลายเป็นความรู้ขององค์กร

## อุปกรณ์และต้นทุน

TSL2591
หัวรับแสง · 200 ฿

Wemos D1 mini
ESP8266 · 89 ฿

1 16

LCD1602 + I²C
จอแสดงผล · 70 ฿
ภาพ: Adafruit Industries (CC BY-SA) · Tpkull / Wikimedia Commons (CC BY-SA 4.0)
LightCheck KM

ต้นทุนจริง
HIOKI FT3424

ถูกที่สุดที่สำ รวจได้

28,184 ฿

HIOKI FT3424 (ญี่ปุ่น, JIS C 1609-1 AA / DIN 5032-7 B) 26,340 ฿ + VAT 7% = 28,183.80 ฿ [7]
~73×

ถูกกว่า แต่ไม่ได้เทียบเท่า: ต้นแบบหลายเครื่อง = คัด
กรองให้ทั่ว · เครื่องมาตรฐาน = ยืนยันผลทางการ

## ใครใช้ประโยชน์ได้อย่างไร

คณะ / ส่วนงาน
ไม่ต้องมีพื้นฐาน: ยืมเครื่อง → จดค่าเมื่อ จอขึ้น * → ส่งจุดเสี่ยงยืนยัน

เจ้าหน้าที่เทคนิค / นักวิจัย ต่อยอด: Wi-Fi + dashboard, เชื่อม SU Green Office, เพิ่ม CO₂/อุณหภูมิ/เสียง

# REFERENCES

1. ทส. (2569). เกณฑ์ Green Office ปี 2569 | 6. Lorenzo et al. (2022). Sensors 22(19), 7107
2. กสร. (2561). มาตรฐานความเข้มแสงสว่าง | 7. HIOKI. FT3424 Lux meter specifications
3. กสร. (2561). หลักเกณฑ์การตรวจวัดแสง | 8. HSE (1997). Lighting at work, HSG38
4. Adafruit. TSL2591 sensor guide | 9. CCOHS (2025). Lighting Ergonomics
5. ams (2018). TSL2591 datasheet | 10. DOE/PNNL (2016). Photometric Flicker

### ให้คนทำ งานได้แสงที่เหมาะกับงานจริง ด้วยเครื่องคัดกรอง (pre‑survey) ต้นทุนต่ำ ที่ตรวจสอบย้อนกลับได้

1

เปลี่ยนความรู้ที่อยู่กับผู้พัฒนา ให้เป็นความรู้ขององค์กร: โค้ด

### SOP คู่มือ ไฟล์ STL ในคลังสาธารณะ

2

### ปรับปรุงแสงด้วยข้อมูลเชิงประจักษ์ตามวงจร PDCA (ตรวจ → แก้ → ตรวจซ้ำ ) ของ Green Office 5.2.1

3

≈ 385 ฿ (89 + 200 + 70 + PLA+ 54 g ≈ 26)

# METHODS

## แนวคิดและกระบวนการดำ เนินงาน

LCD1602A

PCF8574AT

contrast

A0 | A1 | A2 | LED

GND
VCC
SDA
SCL

I2C 0x3F

on

TSL2591
Light Sensor

VIN

3Vo

GND

SCL

SDA

INT

WEMOS

ESP8266EX · Wi-Fi

D1 mini

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
LCD1602 + I²C backpack
มุมมองด้านหลัง · ชิป PCF8574A · ไฟเลียง 5 V

0x3F
TSL2591
Adafruit #1980 · ไฟเลียง 3.3 V

0x29

Wemos D1 mini
ESP8266 · ไฟเลียง USB-C 5 V

SCL

SDA

GND

5V

GND

SCL
SDA

3.3V

3.3V

POWER BANK

แหล่งจ่ายไฟ USB-C 5 V
power bank หรืออะแดปเตอร์มือถือ

USB-C

I²C bus ร่วม 2 สาย

SDA → D2 (GPIO4)

SCL → D1 (GPIO5)

TSL2591 = 0x29
LCD1602 = 0x3F
5V (USB-C) | 3.3V | GND ร่วม
SDA | SCL | จุดต่อแยกสาย

ข้อควรระวัง: backpack PCF8574 หลายรุ่นมีpull-up ≈4.7 kΩ ต่อขึน 5 V ทําให้สาย SDA/SCL ลอยที ≈4.5 V เกินพิกัดขา ESP8266 (VIH สูงสุด 3.6 V) ใช้งานทดลองได้แต่ถ้าสร้างหลายเครือง หรือใช้งานระยะยาว ควรใส่ I²C level shifter (เช่น BSS138) คันระหว่างบัส 3.3 V กับ LCD
ภาพที่ 2 ผังวงจร: I²C ร่วม 2 สาย (SDA = D2, SCL = D1) · TSL2591 0x29 · LCD 0x3F · ไฟเลี้ยง USB-C 5 V จาก power bank

## กล่องพิมพ์ 3 มิติ (ไฟล์ STL เปิดให้ดาวน์โหลด)

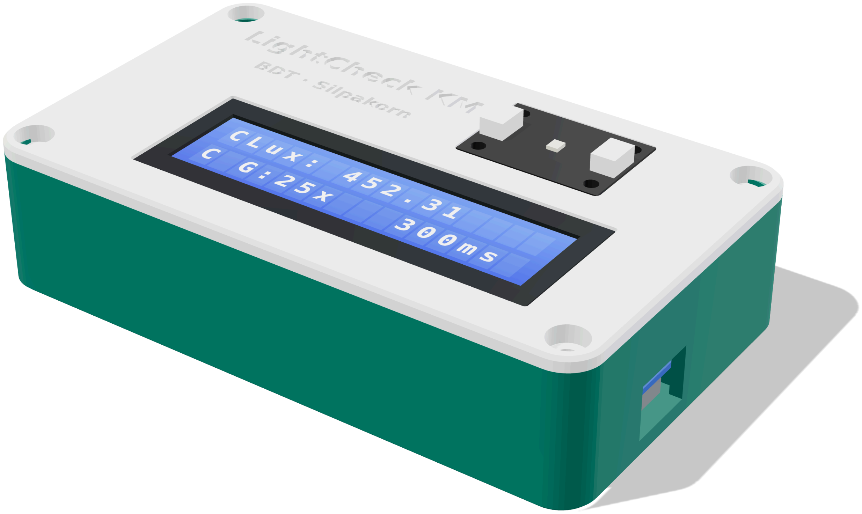
[picture p62: figure]

ภาพที่ 3 Render จากไฟล์ STL · 108×63×26 มม. · หัวรับแสงเสมอผิวฝา ไม่มีขอบบังแสง · ช่องนอต 1/4" ใต้กล่องสำ หรับขาตั้งกล้องที่ระดับ 75 ซม.

ภาพที่ 4 พิมพ์ด้วย Creality Ender-6 ภาพที่ 5 เครื่องที่ประกอบเสร็จ พร้อมใช้

## อัลกอริทึมใน firmware v1.1

1

Self-check I²C ก่อนวัด ป้องกันการบันทึกค่าจากระบบที่ต่อผิด

### 2 ตรวจ saturation ตาม datasheet (36,863 / 65,535 counts) 3 Auto-range มี hysteresis: 100–2,900 lx อ่านที่ gain 25× เสมอ

4

เฉลี่ย 5 รอบ ลดผล LED กะพริบ · จอแสดง * เมื่อค่านิ่ง (CV < 2%) 5

ชดเชย + traceability: บันทึก Raw/Corrected, gain และรุ่นสมการ

บทเรียนหน้างาน: LED สว่างตามขนาดกระแส วูบ 100 ครั้ง/วินาทีจากไฟ

### 50 Hz [10] → integration 300 ms (30 รอบพอดี) + เฉลี่ย 5 ค่า

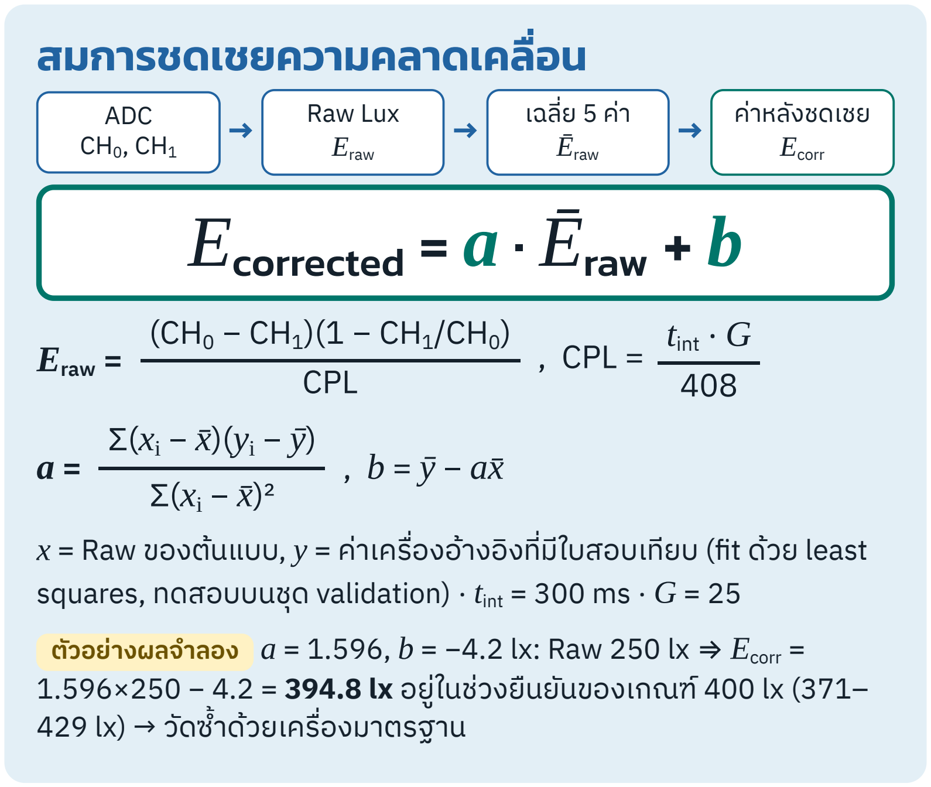
[picture p63: figure]
สมการชดเชยความคลาดเคลื่อน; ADC CH0, CH1; Raw Lux Eraw; เฉลี่ย 5 ค่า Ēraw; ค่าหลังชดเชย Ecorr; Ecorrected = a · Ēraw + b; Eraw =; (CH0 − CH1)(1 − CH1/CH0) CPL; , CPL =; tint · G 408; 429 lx) → วัดซ้ำ ด้วยเครื่องมาตรฐาน

x = Raw ของต้นแบบ, y = ค่าเครื่องอ้างอิงที่มีใบสอบเทียบ (fit ด้วย least squares, ทดสอบบนชุด validation) · tint = 300 ms · G = 25 ตัวอย่างผลจำ ลอง a = 1.596, b = −4.2 lx: Raw 250 lx ⇒ Ecorr 1.596×250 − 4.2 = 394.8 lx อยู่ในช่วงยืนยันของเกณฑ์ 400 lx (371–

# RESULTS

## ผลลัพธ์จากการจัดการความรู้

### ยังไม่มีข้อมูลวัดคู่จริง จึงประเมินด้วยวิธีเชิงอัลกอริทึม: Monte Carlo 5,000 รอบ จาก datasheet TSL2591 + สเปก Hioki FT3424 (±2% rdg.)

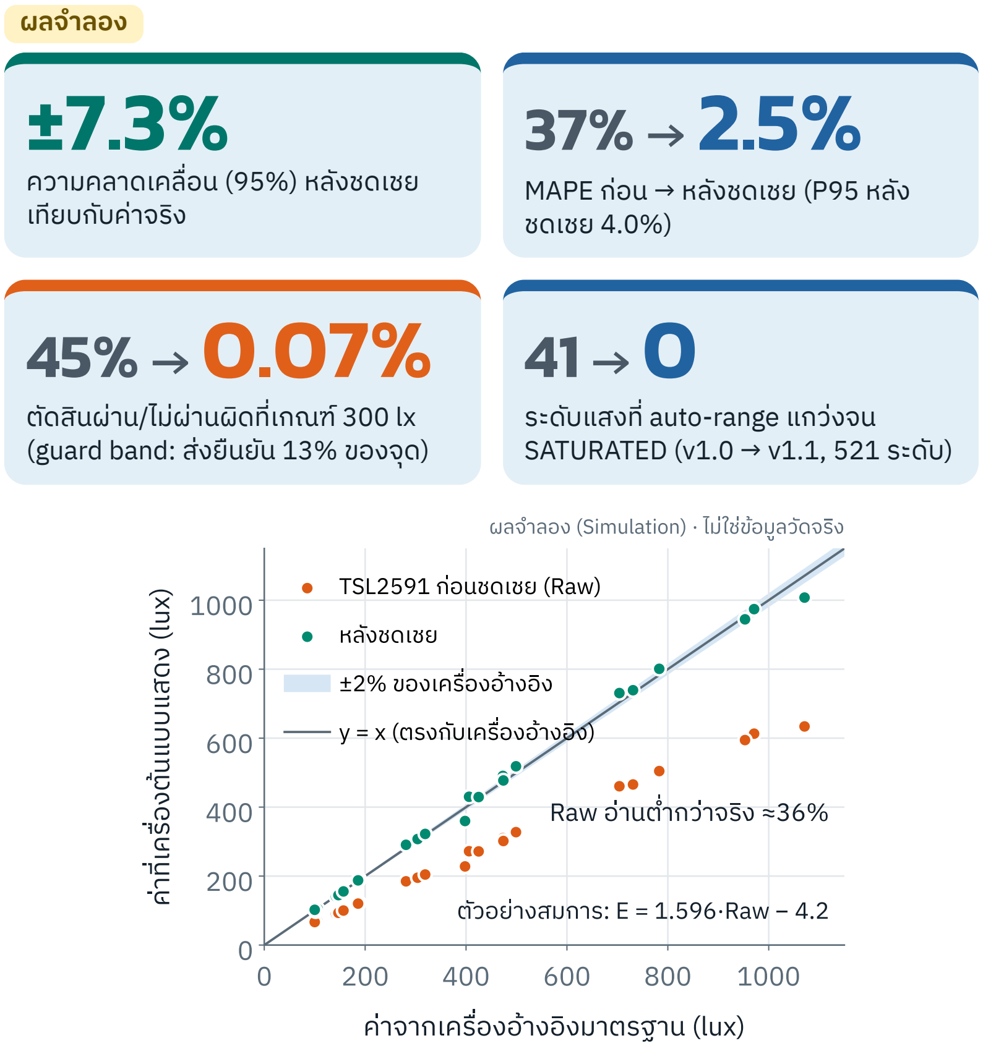
[picture p64: figure]
ผลจำ ลอง ±7.3%; ความคลาดเคลื่อน (95%) หลังชดเชย เทียบกับค่าจริง; MAPE ก่อน → หลังชดเชย (P95 หลัง ชดเชย 4.0%); ตัดสินผ่าน/ไม่ผ่านผิดที่เกณฑ์ 300 lx (guard band: ส่งยืนยัน 13% ของจุด); ระดับแสงที่ auto-range แกว่งจน SATURATED (v1.0 → v1.1, 521 ระดับ)

ภาพที่ 6 ต้นแบบเทียบเครื่องอ้างอิง: ก่อนชดเชยอ่านต่ำ กว่าจริงราว 1/3 (ประมาณจาก

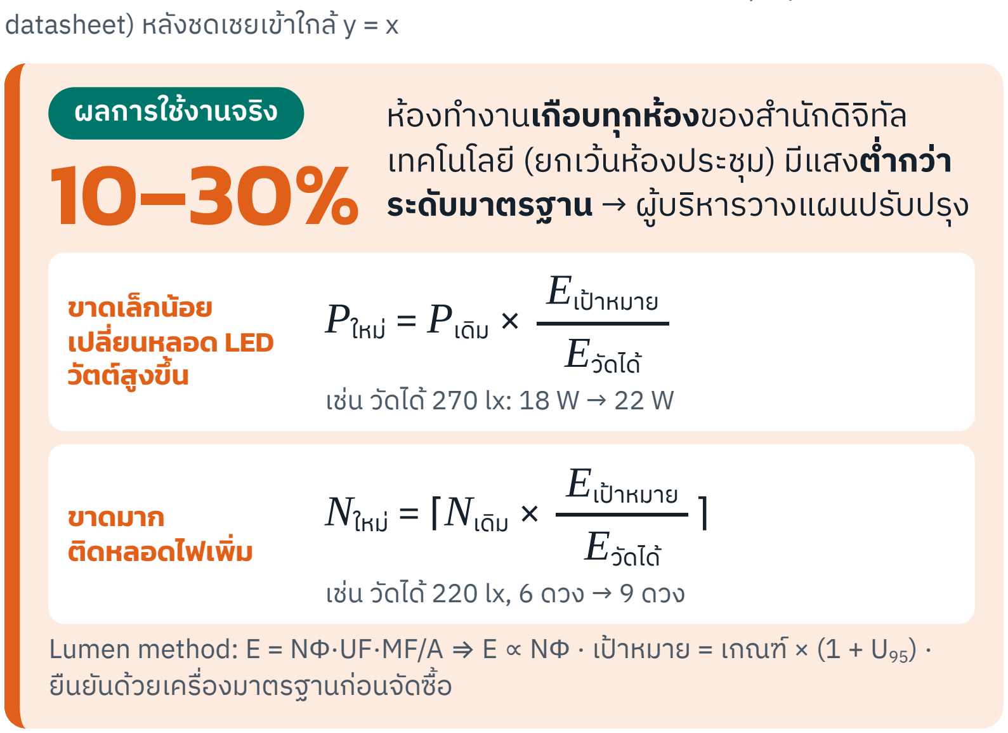
[picture p65: figure]
datasheet) หลังชดเชยเข้าใกล้ y = x; ผลการใช้งานจริง 10–30%; ห้องทำ งานเกือบทุกห้องของสำ นักดิจิทัล; ระดับมาตรฐาน → ผู้บริหารวางแผนปรับปรุง; ขาดเล็กน้อย เปลี่ยนหลอด LED; Pใหม่ = Pเดิม ×; Eเป้าหมาย; Eวัดได้ เช่น วัดได้ 270 lx: 18 W → 22 W; ขาดมาก ติดหลอดไฟเพิ่ม; Nใหม่ = ⌈Nเดิม ×; Eวัดได้; เช่น วัดได้ 220 lx, 6 ดวง → 9 ดวง; ยืนยันด้วยเครื่องมาตรฐานก่อนจัดซื้อ

### เทคโนโลยี (ยกเว้นห้องประชุม) มีแสงต่ำ กว่า

Lumen method: E = NΦ·UF·MF/A ⇒ E ∝ NΦ · เป้าหมาย = เกณฑ์ × (1 + U95) ·

# CONCLUSIONS

## สรุปและบทเรียน

### เปิดให้ร่วมพัฒนาต่อบน GitHub

- วัดคู่จริงกับเครื่องมาตรฐาน | · สมการแยกตามชนิดหลอด
- Wi-Fi logging + dashboard | · ฝากระจายแสง (cosine)
- แผนที่ความสว่างจากกริด | · เซนเซอร์ CO₂/อุณหภูมิ/เสียง

ใช้ได้จริง: เครื่องละ ~385 ฿ พบห้องแสงไม่พอ → แผนปรับปรุงทันที 1.

### บทเรียนหน้างาน: LED วูบ 100 ครั้ง/วินาทีตามไฟ 50 Hz → เฉลี่ย 5

ค่า ค่านิ่งขึ้น ~2.3 เท่า

2.

3 ความรู้เป็นโค้ด SOP คู่มือ STL ที่ทำ ซ้ำ ได้โดยไม่ต้องพึ่งผู้พัฒนา .

### Silpakorn KM Day 2569

### 18 Dec 2026

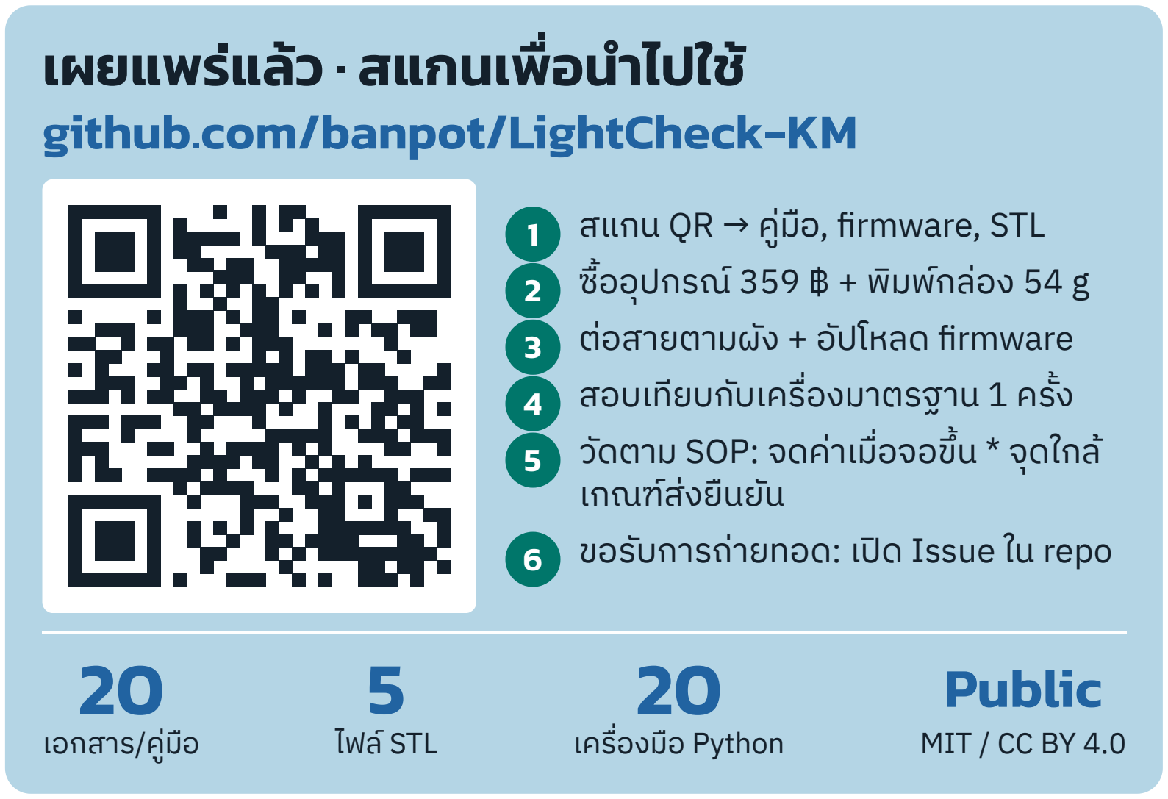
[picture p66: figure]
เผยแพร่แล้ว · สแกนเพื่อนำ ไปใช้ github.com/banpot/LightCheck-KM; เอกสาร/คู่มือ; ไฟล์ STL; เครื่องมือ Python; Public; MIT / CC BY 4.0; 1 สแกน QR → คู่มือ, firmware, STL 2 ซื้ออุปกรณ์ 359 ฿ + พิมพ์กล่อง 54 g 3 ต่อสายตามผัง + อัปโหลด firmware 4 สอบเทียบกับเครื่องมาตรฐาน 1 ครั้ง วัดตาม SOP: จดค่าเมื่อจอขึ้น * จุดใกล้ เกณฑ์ส่งยืนยัน; 6 ขอรับการถ่ายทอด: เปิด Issue ใน repo

### OFFICE THE PRESIDENT SILPAKORN UNIVERSITY

### 22, Borommarachachonani Rd., Talingchan, Bangkok

ตัวเลขที่ติดป้าย ผลจำ ลอง มาจากแบบจำ ลองเชิงอัลกอริทึม ไม่ใช่ข้อมูลวัดจริง สร้างซ้ำ ได้ด้วยคำ สั่ง make all ใน repository
