banpot/LightCheck-KM/docs/lighting-improvement.md

# ผลการใช้งานจริงและแนวทางปรับปรุงแสง (PDCA: Act)

## ผลการคัดกรองจริง ปี 2569

นำ LightCheck KM ไปวัดห้องทำงานของสำนักดิจิทัลเทคโนโลยี พบว่า **ห้องทำงานเกือบทุกห้อง ยกเว้นห้องประชุม
มีแสงต่ำกว่าระดับมาตรฐาน 10–30 %** ผู้บริหารสำนักดิจิทัลเทคโนโลยีจึงวางแผนปรับปรุง 2 แนวทาง

| ระดับที่ขาด | แนวทางของผู้บริหาร | การคำนวณ |
|---|---|---|
| ขาดเล็กน้อย (≤ ~20 %) | เปลี่ยนหลอด LED ให้กำลังวัตต์สูงขึ้นเล็กน้อย | $P_{ใหม่} = P_{เดิม}\times\dfrac{E_{เป้าหมาย}}{E_{วัดได้}}$ แล้วเลือกขนาดหลอดถัดขึ้นไป |
| ขาดมาก (> ~20 %) | ติดหลอดไฟเพิ่ม | $N_{ใหม่} = \left\lceil N_{เดิม}\times\dfrac{E_{เป้าหมาย}}{E_{วัดได้}}\right\rceil$ |

ก่อนจัดซื้อ ให้ยืนยันห้องที่จะลงทุนด้วยเครื่องมาตรฐานที่มีใบสอบเทียบ (ขั้น C ของ PDCA และ guard band ใน SOP)
เพราะค่าจากเครื่องคัดกรองมีความคลาดเคลื่อน และค่าที่ยังไม่ชดเชย (Raw) อาจต่ำกว่าจริง

## ที่มาของสูตร (Lumen method)

$$E = \frac{N\cdot\Phi\cdot UF\cdot MF}{A}$$

- $E$ = ความส่องสว่างเฉลี่ย (lux), $N$ = จำนวนหลอด, $\Phi$ = ฟลักซ์ส่องสว่างต่อหลอด (lm)
- $UF$ = utilization factor, $MF$ = maintenance factor, $A$ = พื้นที่ห้อง (m²)

ห้อง โคม และสภาพผนังเดิม ($UF$, $MF$, $A$ คงที่) ทำให้ $E \propto N\cdot\Phi$ และหลอด LED ชนิดเดียวกันมี
$\Phi = \eta \cdot P$ ($\eta$ = lm/W คงที่) จึงได้

$$k=\frac{E_{เป้าหมาย}}{E_{วัดได้}},\qquad P_{ใหม่}=k\cdot P_{เดิม}\cdot\frac{\eta_{เดิม}}{\eta_{ใหม่}},\qquad N_{ใหม่}=\lceil k\cdot N_{เดิม}\rceil$$

แนะนำให้ตั้ง $E_{เป้าหมาย} = เกณฑ์ \times (1 + U_{95})$ เช่น 300 × 1.073 ≈ 322 lux เพื่อให้ยังผ่านเกณฑ์
แม้มีความคลาดเคลื่อนของการวัดและหลอดเสื่อมตามอายุ

## ตัวอย่าง (โคม 6 ดวง หลอด LED T8 18 W เกณฑ์พื้นที่ 300 lux)

| วัดได้ | ขาด | $k$ | ผลคำนวณ | แนวทาง |
|---|---|---|---|---|
| 270 lx | 10 % | 1.19 | ต้องการ 21.5 W | เปลี่ยนเป็น 22 W (+22 % พลังงาน) |
| 255 lx | 15 % | 1.26 | ต้องการ 22.7 W | เปลี่ยนเป็น 24 W (+33 %) |
| 220 lx | 27 % | 1.46 | 6 × 1.46 = 8.8 → 9 ดวง | ติดเพิ่ม 3 ดวง (+50 %) |

คำนวณด้วย `python tools/survey/lighting_upgrade.py --measured 255 --criterion 300 --lamps 6 --watt 18`
(ปรับขนาดหลอดที่หาซื้อได้ด้วย `--sizes`, ถ้าเปลี่ยนรุ่นที่ประสิทธิภาพต่างกันใส่ `--eta-old` / `--eta-new`)

ข้อควรระวัง: ตรวจกำลังสูงสุดของโคม/driver ก่อนเปลี่ยนวัตต์ ติดโคมเพิ่มฝั่งที่มืดของผังกริด 2 × 2 ม.
เพื่อให้ความสม่ำเสมอดีขึ้น และหลังปรับปรุงให้ตรวจซ้ำที่ตำแหน่งเดิม (ภายใน 90 วันถ้ากระทบผู้ใช้ [3])
