banpot/LightCheck-KM/calibration/sim/fig_cal_error_poster.png

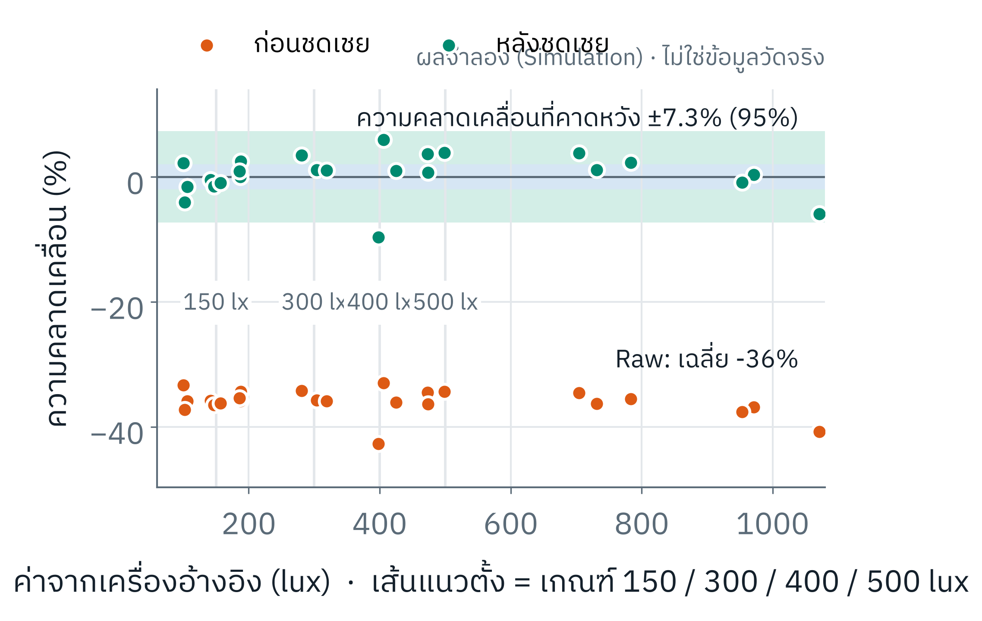
calibration/sim/fig_cal_error_poster.png
