banpot/LightCheck-KM/calibration/sim/fig_decision_poster.png

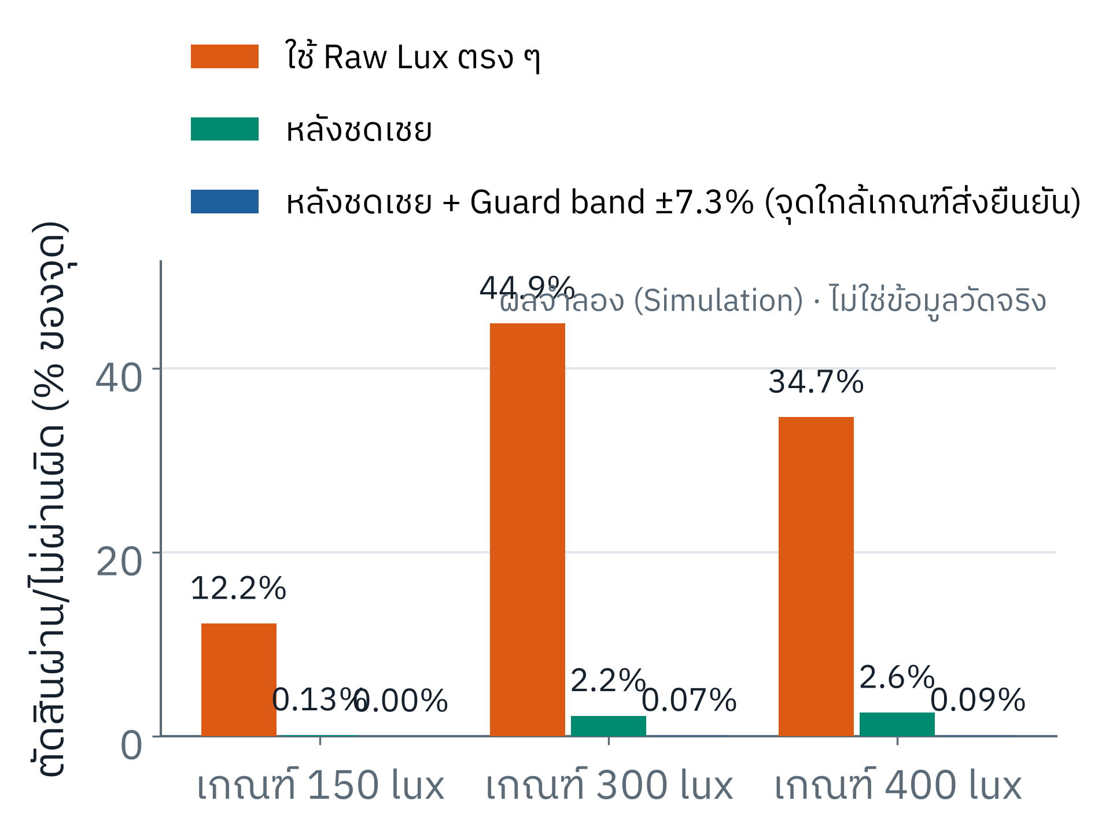
calibration/sim/fig_decision_poster.png
