banpot/LightCheck-KM/calibration/sim/fig_mc_mape_poster.png

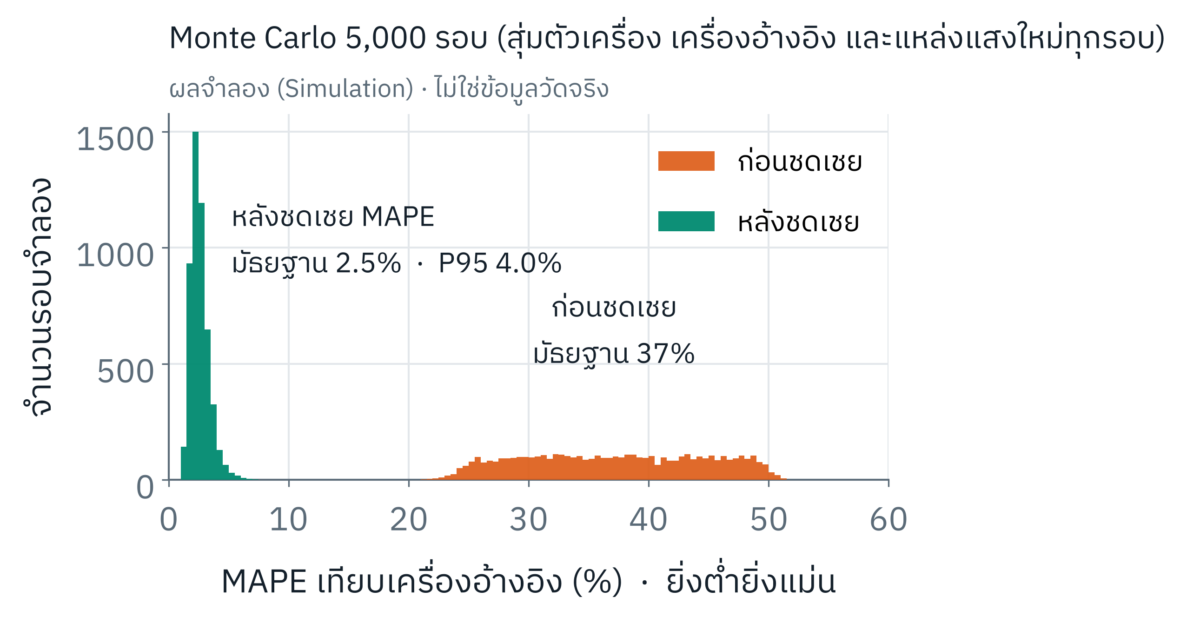
calibration/sim/fig_mc_mape_poster.png
