banpot/LightCheck-KM/docs/img/office_twin_poster.png

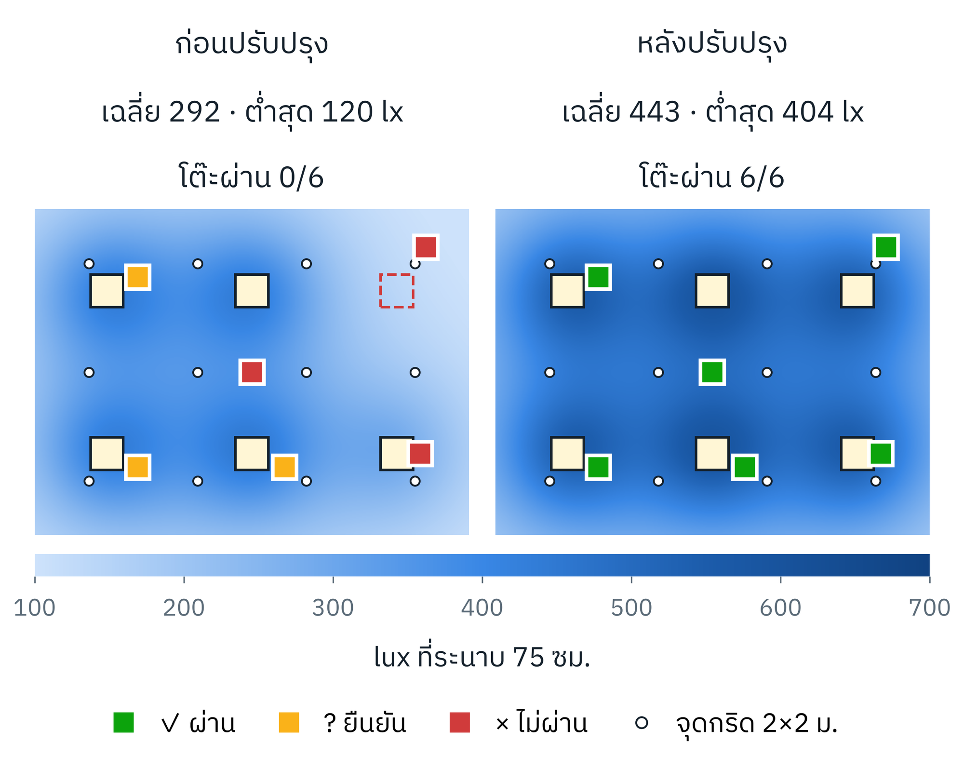
docs/img/office_twin_poster.png
