banpot/LightCheck-KM/hardware/bom.md

# Bill of Materials และต้นทุน

## ต้นทุนจริงของเครื่องต้นแบบ (ราคาที่ซื้อจริง)

| รายการ | ราคา | หมายเหตุ |
|---|---|---|
| Wemos D1 mini (ESP8266) | 89 บาท | ไมโครคอนโทรลเลอร์ + Wi-Fi |
| TSL2591 light sensor | 200 บาท | หัวรับแสง I²C 0x29 |
| LCD1602 + I²C backpack | 70 บาท | จอแสดงผล 16×2 |
| กล่องพิมพ์ 3 มิติ PLA+ ≈ 54 g | ≈ 26 บาท | PLA+ 480 บาท/กก. คิดตามน้ำหนักที่คาดว่าจะใช้ (ด้านล่าง) |
| **รวม** | **≈ 385 บาท** | ไม่รวมสายไฟ สกรู และสาย USB ที่มีอยู่แล้ว |

### น้ำหนักเส้นพลาสติกที่คาดว่าจะใช้

คำนวณด้วย [`hardware/enclosure/src/estimate_filament.py`](enclosure/src/estimate_filament.py)
โดยตัดไฟล์ STL เป็นชั้นละ 0.4 มม. ขอบ 1.2 มม. (3 walls) เป็นเนื้อตัน ผิวบน/ล่าง 0.8 มม. ตัน ที่เหลือ infill 20 %
ความหนาแน่น PLA+ 1.24 g/cm³

| ชิ้นส่วน | ปริมาตรตัน | ปริมาตรที่พิมพ์จริง (โดยประมาณ) | น้ำหนัก |
|---|---|---|---|
| Base | 32.2 cm³ | 29.7 cm³ (92 %) | 36.8 g |
| Lid | 13.2 cm³ | 11.9 cm³ (90 %) | 14.7 g |
| Skirt / purge | – | – | 2.0 g |
| **รวม** | | | **≈ 53.6 g → 53.6 × 0.48 ≈ 25.7 บาท** |

กล่องผนังบาง (2 มม.) จึงเป็นเนื้อตันเกือบทั้งหมด infill มีผลน้อย ค่าจริงให้ยืนยันจากน้ำหนักที่ slicer รายงาน

## เทียบกับเครื่องมาตรฐาน

| รายการ | ราคา | คุณลักษณะ |
|---|---|---|
| LightCheck KM | ≈ 385 บาท | pre-survey, Raw + Corrected, traceability |
| **HIOKI FT3424** (ญี่ปุ่น) — เครื่องมาตรฐานที่ราคาต่ำที่สุดที่สำรวจได้ในตลาดไทย | 26,340 บาท + VAT 7 % = **28,183.80 บาท** [7][11] | 20–200,000 lx; JIS C 1609-1:2006 general AA / DIN 5032-7 class B; linearity ±2 % rdg. |

ต้นแบบอยู่ราว **1.4 %** ของราคา HIOKI FT3424 รวม VAT (ถูกกว่าประมาณ **73 เท่า**) แต่ไม่ได้ "เทียบเท่า" เครื่องมาตรฐาน
เพราะต่างกันด้านมาตรฐาน ใบสอบเทียบ spectral/cosine response และการรับรอง
จึงใช้ต้นแบบหลายเครื่องทำ pre-survey และใช้เครื่องมาตรฐานจำนวนน้อยเป็น reference / verification

ราคาอ้างอิงจากเว็บตอนยื่นแบบฟอร์ม KM (10 ส.ค. 2569): TSL2591 226.22 บาท [8], D1 mini 97 บาท [9], LCD1602 I²C 65 บาท [10]
อ้างอิงหมายเลขตาม [docs/references.md](../docs/references.md)
