banpot/LightCheck-KM/calibration/sim/representative_campaign.csv

# SIMULATED DATA - generated by simulate_calibration.py - NOT real measurements
session | role | point_id | raw_lux | ref_lux | gain | tint_ms | source | notes
SIM-S1 | fit | SIM-fit-01 | 56.18 | 95 | 25x | 300 | mixed-daylight | SIMULATED true=95.4
SIM-S1 | fit | SIM-fit-02 | 58.48 | 93 | 25x | 300 | LED4000K | SIMULATED true=94.1
SIM-S1 | fit | SIM-fit-03 | 66.12 | 100 | 25x | 300 | LED4000K | SIMULATED true=100.6
SIM-S1 | fit | SIM-fit-04 | 64.09 | 96 | 25x | 300 | LED6500K | SIMULATED true=96.0
SIM-S1 | fit | SIM-fit-05 | 92.68 | 153 | 25x | 300 | T8 | SIMULATED true=155.2
SIM-S1 | fit | SIM-fit-06 | 97.15 | 154 | 25x | 300 | LED4000K | SIMULATED true=154.5
SIM-S1 | fit | SIM-fit-07 | 102.31 | 162 | 25x | 300 | T8 | SIMULATED true=161.9
SIM-S1 | fit | SIM-fit-08 | 98.25 | 154 | 25x | 300 | LED4000K | SIMULATED true=155.1
SIM-S1 | fit | SIM-fit-09 | 129.53 | 199 | 25x | 300 | LED4000K | SIMULATED true=199.3
SIM-S1 | fit | SIM-fit-10 | 134.20 | 208 | 25x | 300 | LED4000K | SIMULATED true=209.2
SIM-S1 | fit | SIM-fit-11 | 105.84 | 185 | 25x | 300 | mixed-daylight | SIMULATED true=185.7
SIM-S1 | fit | SIM-fit-12 | 129.68 | 201 | 25x | 300 | LED4000K | SIMULATED true=202.8
SIM-S1 | fit | SIM-fit-13 | 191.29 | 290 | 25x | 300 | LED6500K | SIMULATED true=291.2
SIM-S1 | fit | SIM-fit-14 | 199.45 | 309 | 25x | 300 | LED6500K | SIMULATED true=311.7
SIM-S1 | fit | SIM-fit-15 | 191.14 | 291 | 25x | 300 | T8 | SIMULATED true=292.3
SIM-S1 | fit | SIM-fit-16 | 183.09 | 288 | 25x | 300 | LED4000K | SIMULATED true=287.8
SIM-S1 | fit | SIM-fit-17 | 276.20 | 406 | 25x | 300 | LED3000K | SIMULATED true=407.4
SIM-S1 | fit | SIM-fit-18 | 265.42 | 397 | 25x | 300 | LED4000K | SIMULATED true=400.4
SIM-S1 | fit | SIM-fit-19 | 250.90 | 392 | 25x | 300 | LED4000K | SIMULATED true=395.0
SIM-S1 | fit | SIM-fit-20 | 256.47 | 402 | 25x | 300 | LED4000K | SIMULATED true=407.1
SIM-S1 | fit | SIM-fit-21 | 274.55 | 471 | 25x | 300 | mixed-daylight | SIMULATED true=475.8
SIM-S1 | fit | SIM-fit-22 | 314.04 | 494 | 25x | 300 | T8 | SIMULATED true=496.3
SIM-S1 | fit | SIM-fit-23 | 308.26 | 469 | 25x | 300 | LED4000K | SIMULATED true=474.9
SIM-S1 | fit | SIM-fit-24 | 331.35 | 513 | 25x | 300 | LED6500K | SIMULATED true=515.1
SIM-S1 | fit | SIM-fit-25 | 466.38 | 720 | 25x | 300 | LED4000K | SIMULATED true=722.6
SIM-S1 | fit | SIM-fit-26 | 448.81 | 697 | 25x | 300 | LED4000K | SIMULATED true=696.4
SIM-S1 | fit | SIM-fit-27 | 452.03 | 764 | 25x | 300 | mixed-daylight | SIMULATED true=766.7
SIM-S1 | fit | SIM-fit-28 | 451.85 | 713 | 25x | 300 | LED4000K | SIMULATED true=716.4
SIM-S1 | fit | SIM-fit-29 | 667.67 | 1019 | 25x | 300 | LED4000K | SIMULATED true=1021.5
SIM-S1 | fit | SIM-fit-30 | 591.03 | 934 | 25x | 300 | LED4000K | SIMULATED true=937.3
SIM-S1 | fit | SIM-fit-31 | 603.10 | 970 | 25x | 300 | T8 | SIMULATED true=978.3
SIM-S1 | fit | SIM-fit-32 | 553.78 | 951 | 25x | 300 | mixed-daylight | SIMULATED true=954.2
SIM-S2 | val | SIM-val-01 | 68.00 | 106 | 25x | 300 | LED4000K | SIMULATED true=106.5
SIM-S2 | val | SIM-val-02 | 63.97 | 102 | 25x | 300 | LED4000K | SIMULATED true=103.6
SIM-S2 | val | SIM-val-03 | 66.69 | 100 | 25x | 300 | LED4000K | SIMULATED true=100.5
SIM-S2 | val | SIM-val-04 | 91.18 | 142 | 25x | 300 | LED4000K | SIMULATED true=142.3
SIM-S2 | val | SIM-val-05 | 93.36 | 147 | 25x | 300 | LED4000K | SIMULATED true=147.6
SIM-S2 | val | SIM-val-06 | 100.07 | 157 | 25x | 300 | LED4000K | SIMULATED true=157.6
SIM-S2 | val | SIM-val-07 | 123.38 | 188 | 25x | 300 | LED6500K | SIMULATED true=188.8
SIM-S2 | val | SIM-val-08 | 119.84 | 187 | 25x | 300 | LED4000K | SIMULATED true=187.9
SIM-S2 | val | SIM-val-09 | 120.20 | 186 | 25x | 300 | LED4000K | SIMULATED true=187.5
SIM-S2 | val | SIM-val-10 | 184.80 | 281 | 25x | 300 | LED6500K | SIMULATED true=281.5
SIM-S2 | val | SIM-val-11 | 195.25 | 304 | 25x | 300 | LED4000K | SIMULATED true=305.6
SIM-S2 | val | SIM-val-12 | 204.54 | 319 | 25x | 300 | LED4000K | SIMULATED true=321.9
SIM-S2 | val | SIM-val-13 | 272.08 | 406 | 25x | 300 | LED3000K | SIMULATED true=408.4
SIM-S2 | val | SIM-val-14 | 228.00 | 398 | 25x | 300 | mixed-daylight | SIMULATED true=400.8
SIM-S2 | val | SIM-val-15 | 271.56 | 425 | 25x | 300 | LED4000K | SIMULATED true=428.4
SIM-S2 | val | SIM-val-16 | 327.44 | 499 | 25x | 300 | LED6500K | SIMULATED true=502.7
SIM-S2 | val | SIM-val-17 | 309.94 | 473 | 25x | 300 | LED4000K | SIMULATED true=477.5
SIM-S2 | val | SIM-val-18 | 301.72 | 474 | 25x | 300 | LED4000K | SIMULATED true=477.6
SIM-S2 | val | SIM-val-19 | 465.67 | 731 | 25x | 300 | LED4000K | SIMULATED true=733.5
SIM-S2 | val | SIM-val-20 | 504.54 | 783 | 25x | 300 | LED4000K | SIMULATED true=789.0
SIM-S2 | val | SIM-val-21 | 460.49 | 704 | 25x | 300 | LED4000K | SIMULATED true=711.0
SIM-S2 | val | SIM-val-22 | 613.00 | 971 | 25x | 300 | LED4000K | SIMULATED true=978.0
SIM-S2 | val | SIM-val-23 | 594.45 | 953 | 25x | 300 | T8 | SIMULATED true=956.5
SIM-S2 | val | SIM-val-24 | 633.96 | 1071 | 25x | 300 | mixed-daylight | SIMULATED true=1075.4
