banpot/LightCheck-KM/hardware/enclosure/stl/proxies/_lid_assembled.stl

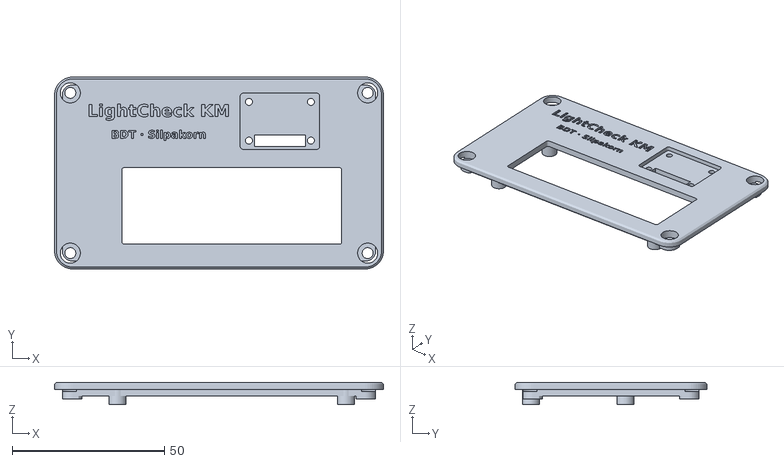
[picture p71: CAD file, 2026-10-27]
hardware/enclosure/stl/proxies/_lid_assembled.stl
108.0 x 63.0 x 7.30
