banpot/LightCheck-KM/hardware/enclosure/stl/fit_test/hole_fit_test.stl

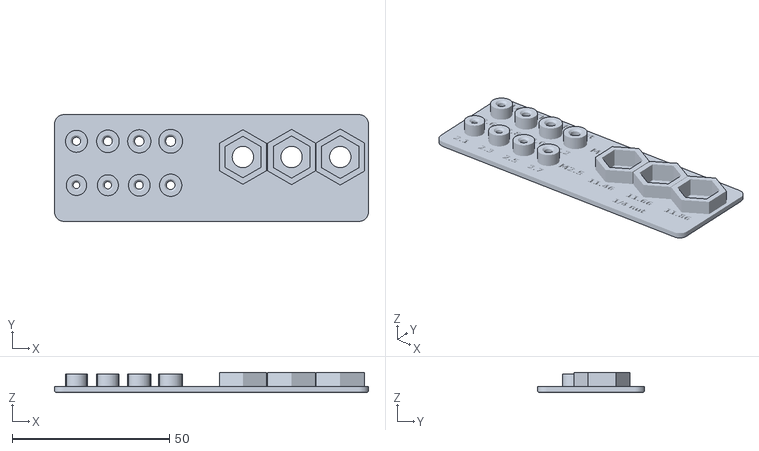
[picture p72: CAD file, 2026-10-27]
hardware/enclosure/stl/fit_test/hole_fit_test.stl
100.0 x 34.0 x 6.50
