banpot/LightCheck-KM/hardware/enclosure/stl/lightcheck_base.stl

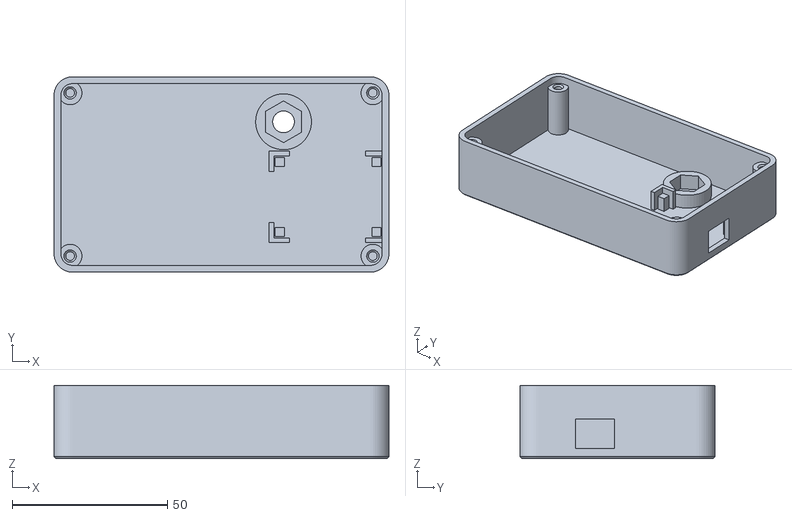
[picture p73: CAD file, 2026-10-27]
hardware/enclosure/stl/lightcheck_base.stl
108.0 x 63.0 x 23.6
