banpot/LightCheck-KM/hardware/enclosure/stl/loose/lightcheck_base_loose.stl

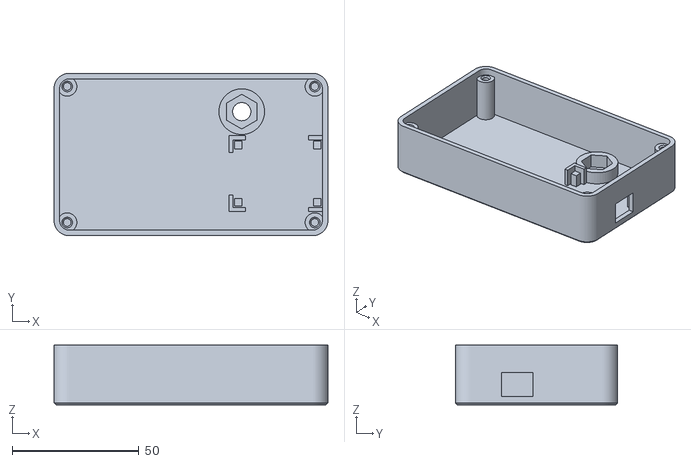
[picture p74: CAD file, 2026-10-27]
hardware/enclosure/stl/loose/lightcheck_base_loose.stl
108.0 x 64.0 x 23.6
