banpot/LightCheck-KM/hardware/enclosure/stl/proxies/tsl_header.stl

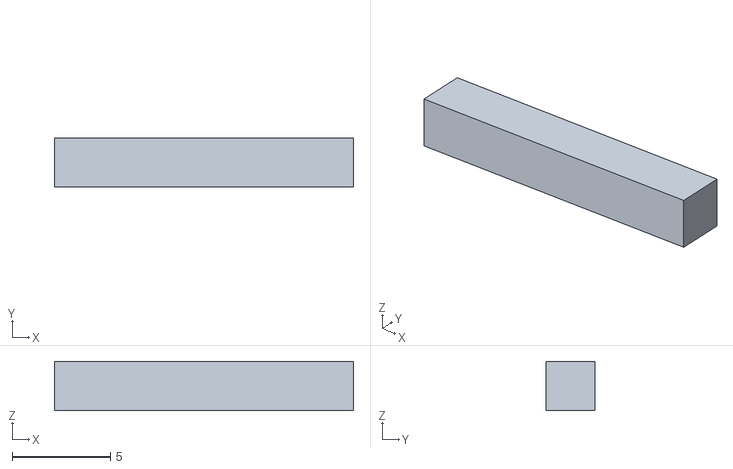
[picture p75: CAD file, 2026-10-27]
hardware/enclosure/stl/proxies/tsl_header.stl
15.2 x 2.50 x 2.50
