banpot/LightCheck-KM/hardware/enclosure/stl/loose/lightcheck_lid_loose.stl

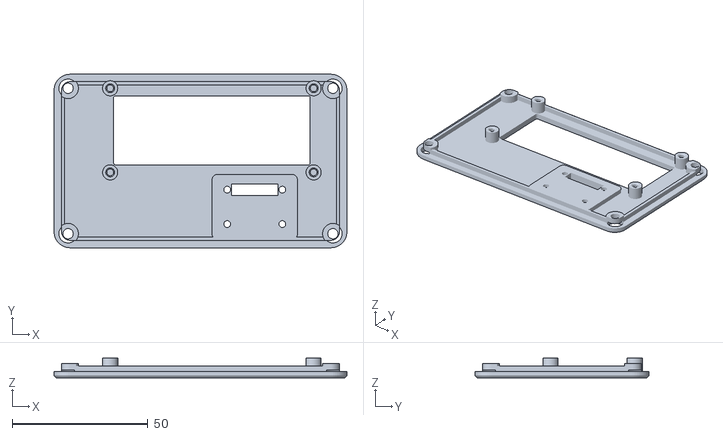
[picture p76: CAD file, 2026-10-27]
hardware/enclosure/stl/loose/lightcheck_lid_loose.stl
108.0 x 64.0 x 7.30
