banpot/LightCheck-KM/hardware/enclosure/stl/proxies/tsl_pcb.stl

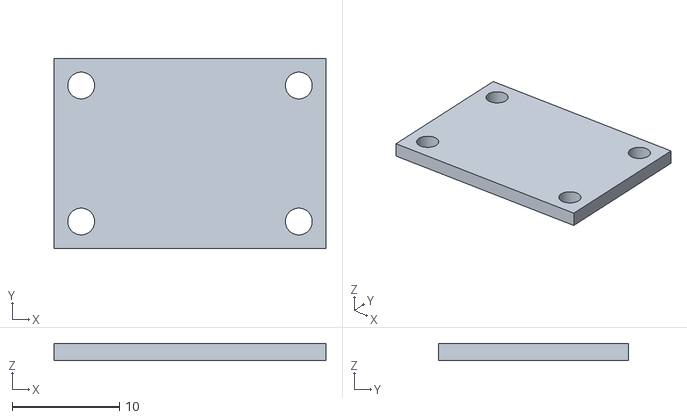
[picture p77: CAD file, 2026-10-27]
hardware/enclosure/stl/proxies/tsl_pcb.stl
25.4 x 17.8 x 1.60
