banpot/LightCheck-KM/hardware/enclosure/stl/proxies/tsl_sensor.stl

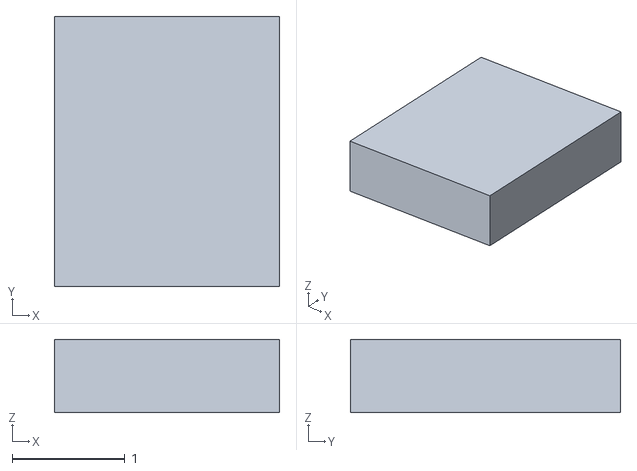
[picture p78: CAD file, 2026-10-27]
hardware/enclosure/stl/proxies/tsl_sensor.stl
2.00 x 2.40 x 0.65
