banpot/LightCheck-KM/hardware/enclosure/stl/proxies/d1_bottom.stl

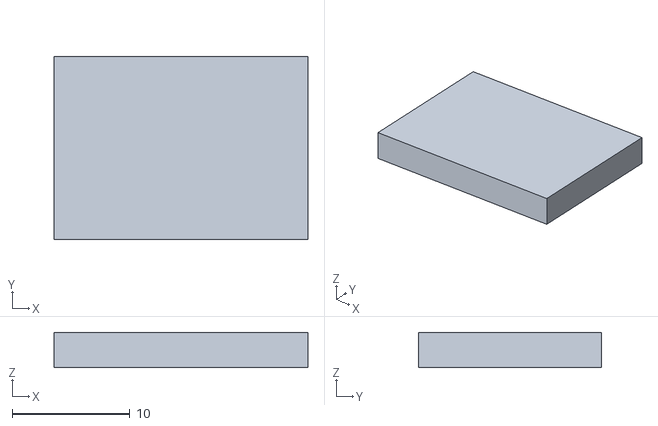
[picture p79: CAD file, 2026-10-27]
hardware/enclosure/stl/proxies/d1_bottom.stl
21.6 x 15.6 x 3.00
