banpot/LightCheck-KM/hardware/enclosure/stl/proxies/d1_usb.stl

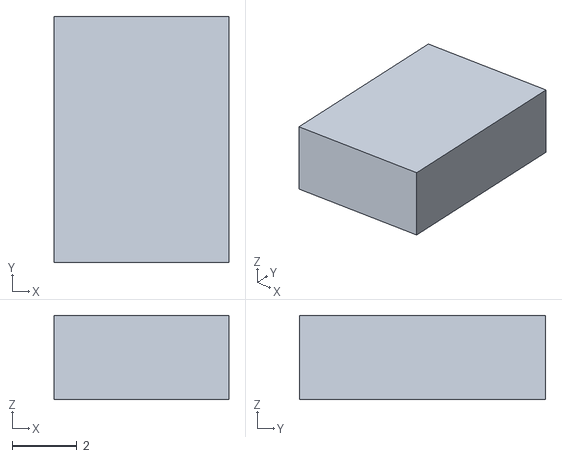
[picture p80: CAD file, 2026-10-27]
hardware/enclosure/stl/proxies/d1_usb.stl
5.40 x 7.60 x 2.60
