banpot/LightCheck-KM/hardware/enclosure/stl/proxies/tsl_pins.stl

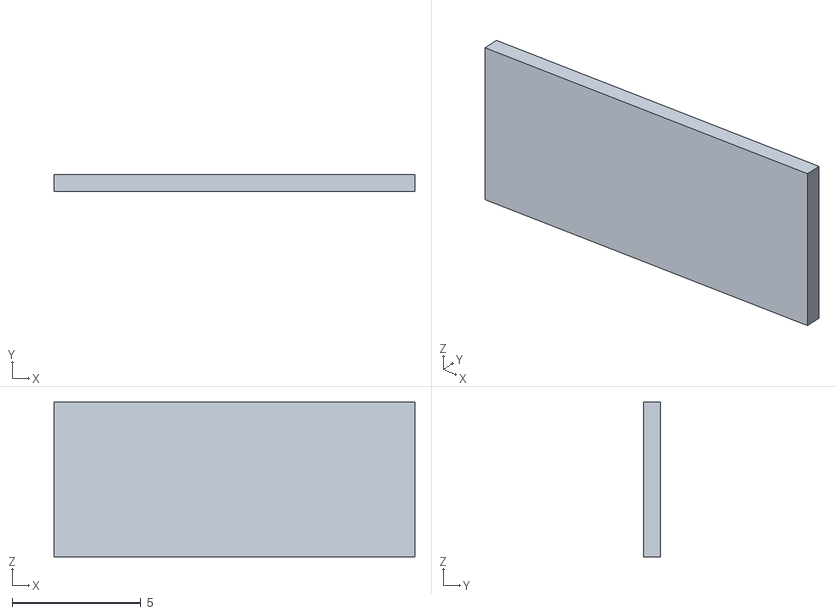
[picture p81: CAD file, 2026-10-27]
hardware/enclosure/stl/proxies/tsl_pins.stl
14.0 x 0.64 x 6.00
