banpot/LightCheck-KM/hardware/enclosure/stl/proxies/d1_pcb.stl

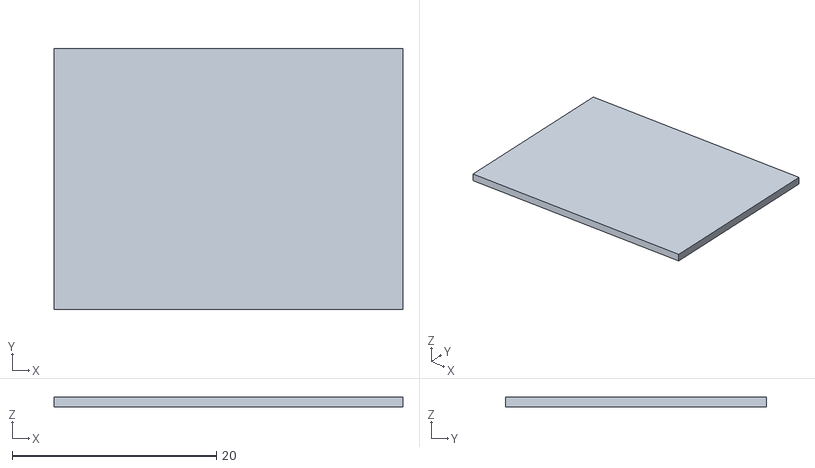
[picture p82: CAD file, 2026-10-27]
hardware/enclosure/stl/proxies/d1_pcb.stl
34.2 x 25.6 x 1.00
