banpot/LightCheck-KM/hardware/enclosure/stl/proxies/tsl_jst.stl

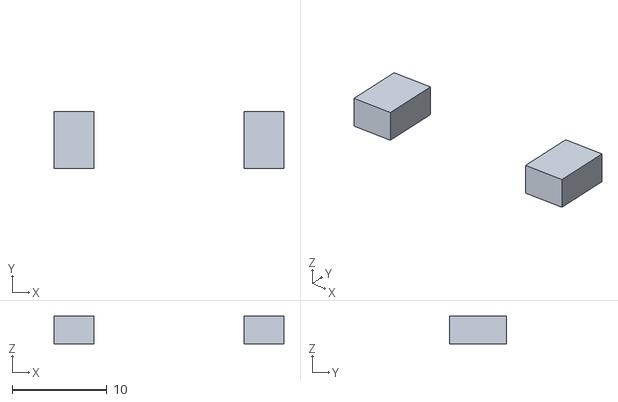
[picture p83: CAD file, 2026-10-27]
hardware/enclosure/stl/proxies/tsl_jst.stl
24.3 x 6.00 x 2.95
