banpot/LightCheck-KM/hardware/enclosure/stl/proxies/d1_shield.stl

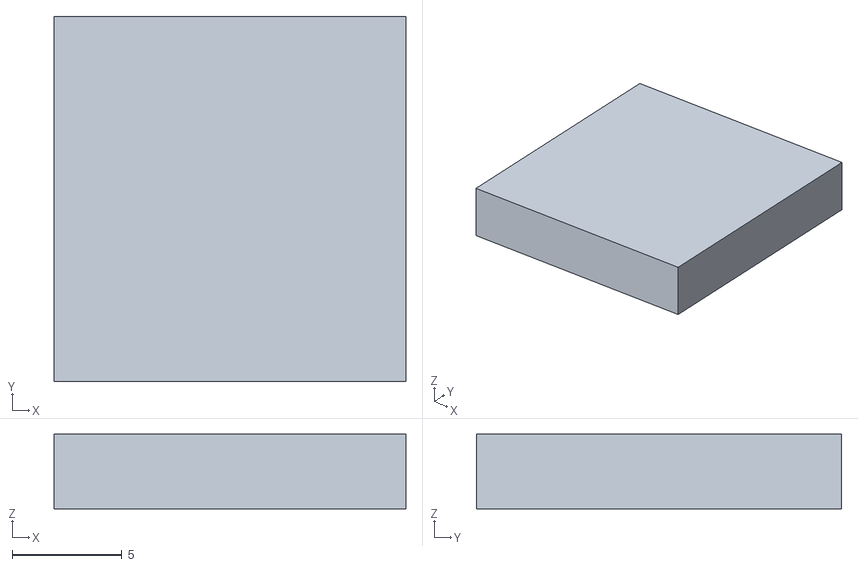
[picture p84: CAD file, 2026-10-27]
hardware/enclosure/stl/proxies/d1_shield.stl
16.0 x 16.6 x 3.40
