banpot/LightCheck-KM/hardware/enclosure/stl/proxies/lcd_i2c_pins.stl

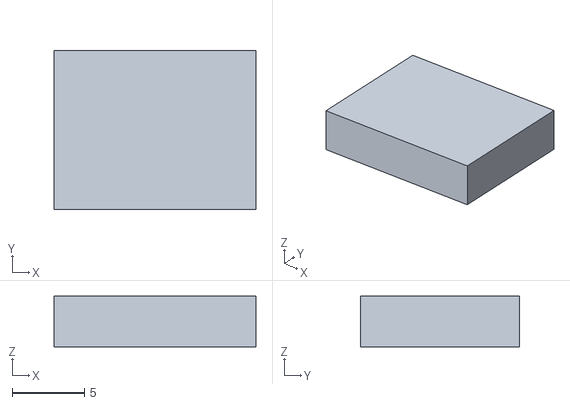
[picture p85: CAD file, 2026-10-23]
hardware/enclosure/stl/proxies/lcd_i2c_pins.stl
14.0 x 11.0 x 3.50
