banpot/LightCheck-KM/hardware/enclosure/stl/proxies/lcd_bezel.stl

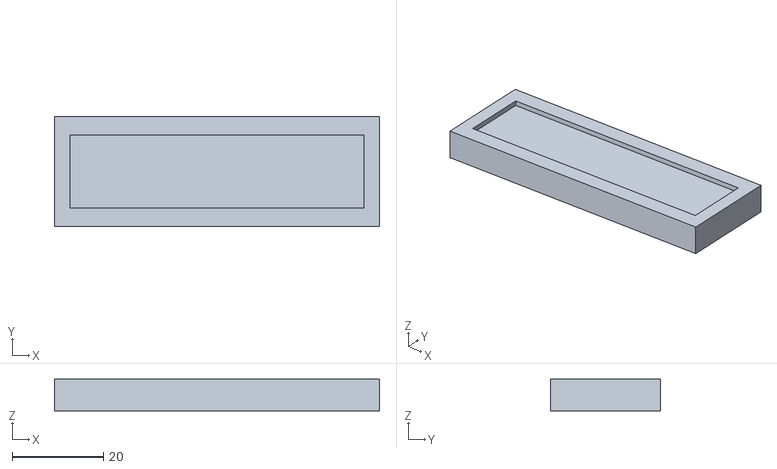
[picture p86: CAD file, 2026-10-23]
hardware/enclosure/stl/proxies/lcd_bezel.stl
71.2 x 24.2 x 7.00
