banpot/LightCheck-KM/hardware/enclosure/stl/proxies/lcd_trimpot.stl

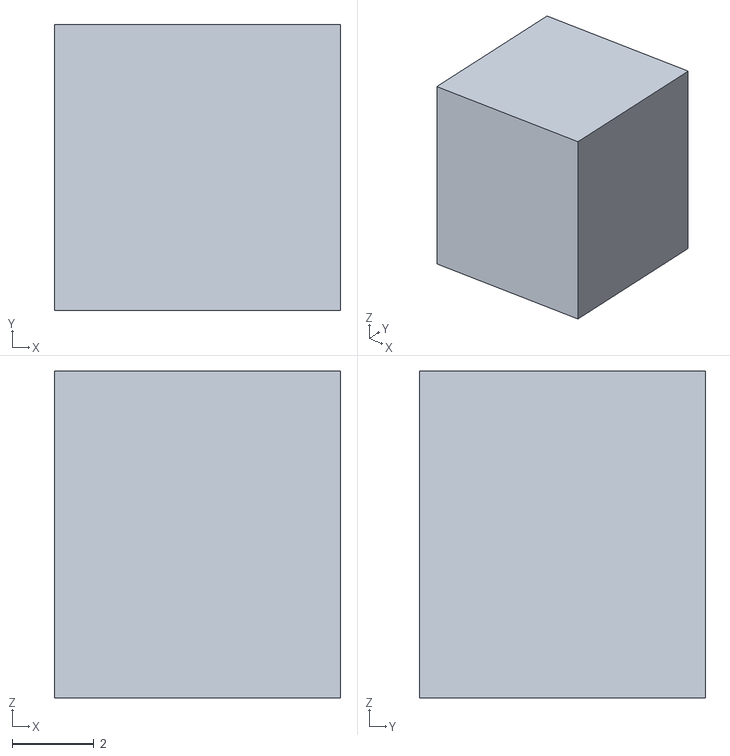
[picture p87: CAD file, 2026-10-23]
hardware/enclosure/stl/proxies/lcd_trimpot.stl
7.00 x 7.00 x 8.00
