banpot/LightCheck-KM/hardware/enclosure/stl/proxies/lcd_header.stl

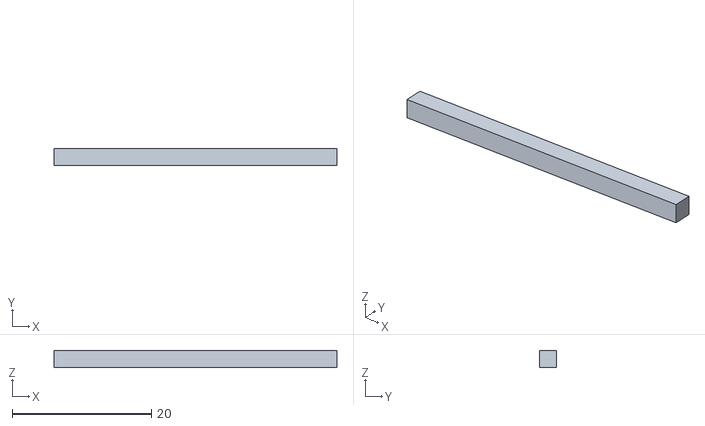
[picture p88: CAD file, 2026-10-23]
hardware/enclosure/stl/proxies/lcd_header.stl
40.6 x 2.50 x 2.50
