banpot/LightCheck-KM/hardware/enclosure/stl/proxies/lcd_backpack.stl

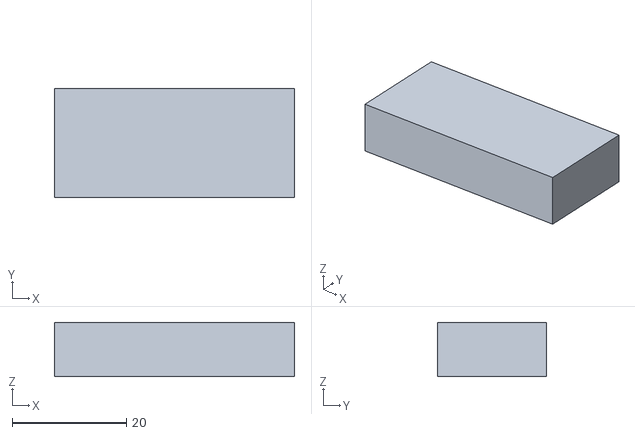
[picture p89: CAD file, 2026-10-23]
hardware/enclosure/stl/proxies/lcd_backpack.stl
42.0 x 19.0 x 9.50
