banpot/LightCheck-KM/hardware/enclosure/stl/proxies/lcd_glass.stl

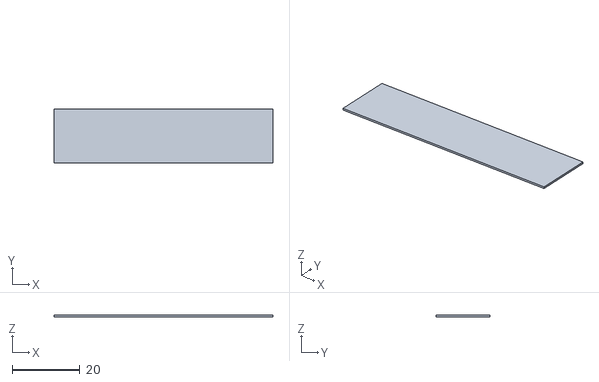
[picture p90: CAD file, 2026-10-23]
hardware/enclosure/stl/proxies/lcd_glass.stl
64.5 x 16.0 x 0.5
