banpot/LightCheck-KM/hardware/enclosure/stl/proxies/lcd_pcb.stl

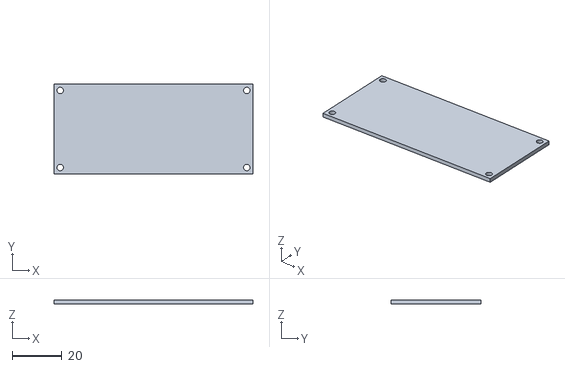
[picture p91: CAD file, 2026-10-23]
hardware/enclosure/stl/proxies/lcd_pcb.stl
80.0 x 36.0 x 1.60
