banpot/LightCheck-KM/(list of files, cad)

Other CAD files:
hardware/enclosure/stl/lightcheck_lid.stl
