banpot/LightCheck-KM/evidence/2026-10_enclosure-print/printing_creality-ender-6_PLA+.jpg

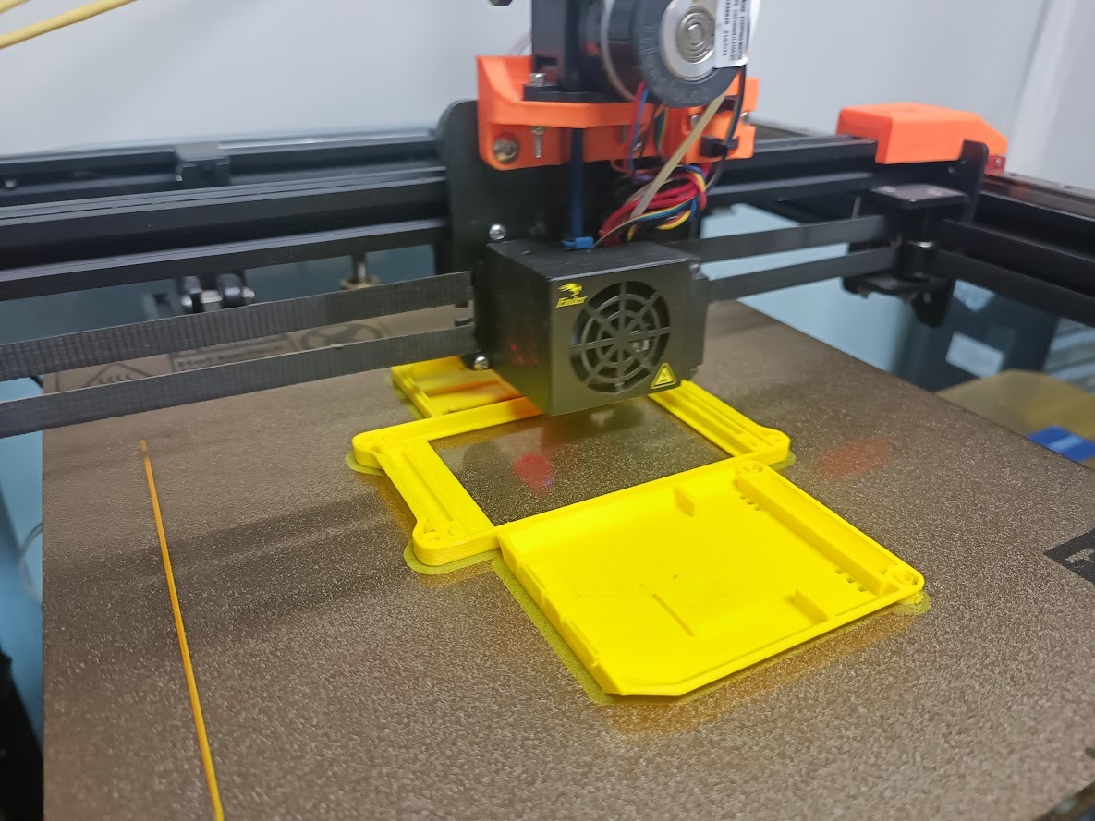
evidence/2026-10_enclosure-print/printing_creality-ender-6_PLA+.jpg
