banpot/LightCheck-KM/evidence/2026-10_prototype/lightcheck-km_assembled_v1.1.jpg

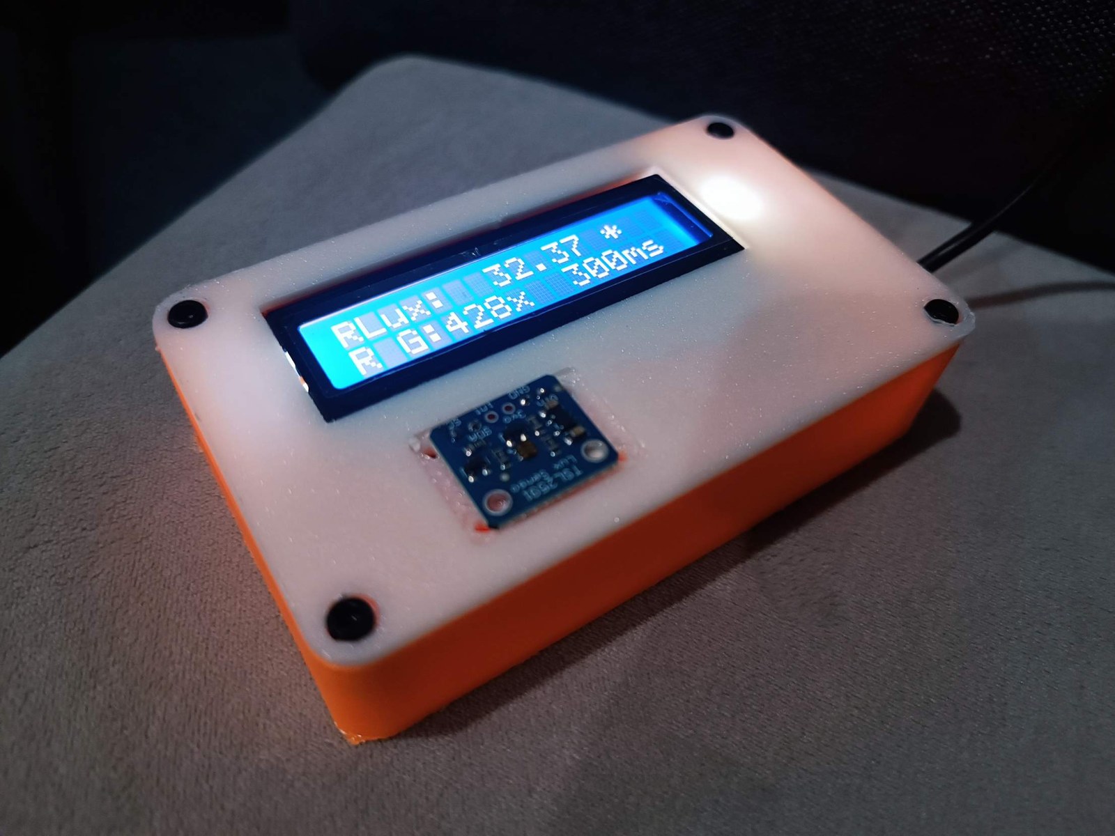
evidence/2026-10_prototype/lightcheck-km_assembled_v1.1.jpg
