banpot/LightCheck-KM/evidence/2026-10_prototype/printing_lid_creality-ender-6.jpg

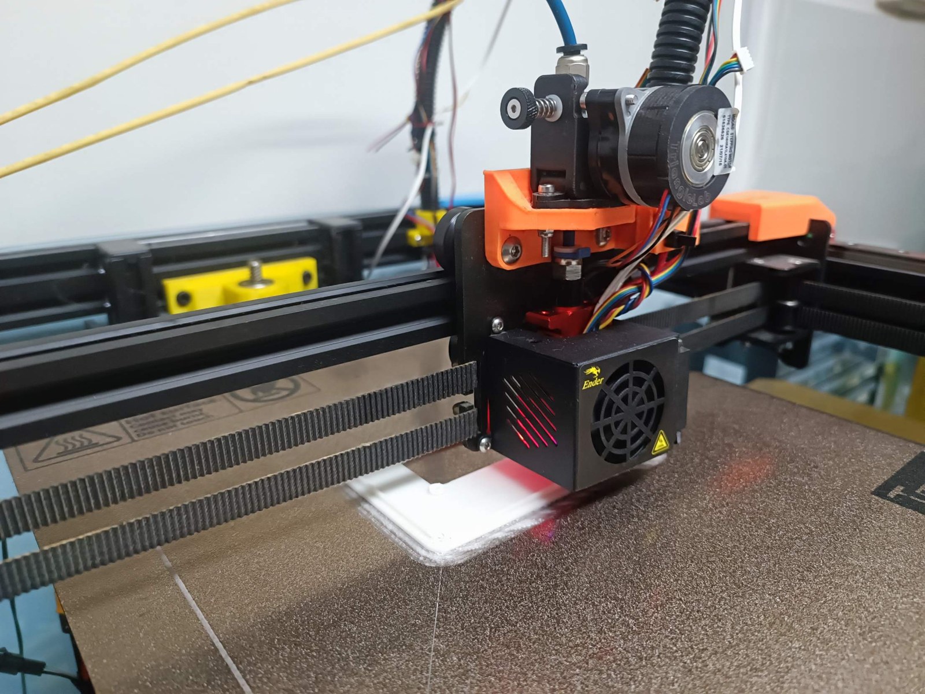
evidence/2026-10_prototype/printing_lid_creality-ender-6.jpg
