banpot/LightCheck-KM/tools/fw_sim/results.txt

== v10 | device MED/HIGH gain = 24.5 400 (library assumes 25 / 428)
  ascending sweep        levels= 521 hunting= 41 showsSAT= 41  office(100-2900lx) on MED: 121/170
  descending sweep       levels= 521 hunting= 40 showsSAT= 40  office(100-2900lx) on MED: 122/171
  dark->office jumps     levels=  70 hunting=  1 showsSAT=  1  office(100-2900lx) on MED: 50/70
== v10 | device MED/HIGH gain = 22 440 (library assumes 25 / 428)
  ascending sweep        levels= 521 hunting= 41 showsSAT= 41  office(100-2900lx) on MED: 115/170
  descending sweep       levels= 521 hunting= 40 showsSAT= 40  office(100-2900lx) on MED: 127/171
  dark->office jumps     levels=  70 hunting=  5 showsSAT=  5  office(100-2900lx) on MED: 52/70
== v10 | device MED/HIGH gain = 27 360 (library assumes 25 / 428)
  ascending sweep        levels= 521 hunting= 50 showsSAT= 50  office(100-2900lx) on MED: 116/170
  descending sweep       levels= 521 hunting= 49 showsSAT= 49  office(100-2900lx) on MED: 126/171
  dark->office jumps     levels=  70 hunting=  0 showsSAT=  0  office(100-2900lx) on MED: 48/70
== current | device MED/HIGH gain = 24.5 400 (library assumes 25 / 428)
  ascending sweep        levels= 521 hunting=  0 showsSAT=  0  office(100-2900lx) on MED: 169/170
  descending sweep       levels= 521 hunting=  0 showsSAT=  0  office(100-2900lx) on MED: 171/171
  dark->office jumps     levels=  70 hunting=  0 showsSAT=  0  office(100-2900lx) on MED: 69/70
== current | device MED/HIGH gain = 22 440 (library assumes 25 / 428)
  ascending sweep        levels= 521 hunting=  0 showsSAT=  0  office(100-2900lx) on MED: 170/170
  descending sweep       levels= 521 hunting=  0 showsSAT=  0  office(100-2900lx) on MED: 171/171
  dark->office jumps     levels=  70 hunting=  0 showsSAT=  0  office(100-2900lx) on MED: 70/70
== current | device MED/HIGH gain = 27 360 (library assumes 25 / 428)
  ascending sweep        levels= 521 hunting=  0 showsSAT=  0  office(100-2900lx) on MED: 164/170
  descending sweep       levels= 521 hunting=  0 showsSAT=  0  office(100-2900lx) on MED: 171/171
  dark->office jumps     levels=  70 hunting=  0 showsSAT=  0  office(100-2900lx) on MED: 67/70

== stabilisation (rolling mean of 5, '*' when CV < 2 %) at 400 lx ==
jitter/reading  CV(single raw)  CV(LCD value)  readings with '*'
     0.3 %          0.30 %          0.12 %          100.0 %
     0.7 %          0.70 %          0.33 %          100.0 %
     1.5 %          1.50 %          0.64 %           91.2 %
     3.0 %          3.00 %          1.53 %           18.5 %
     6.0 %          6.00 %          2.61 %            1.0 %

== boot: I2C scan + LCD auto-detect (0x3F, 0x27, missing, plugged in later) ==
---- LCD backpack at 0x3F ----
I2C scan: 0x29 0x3F
LCD found at 0x3F
----------------------------------
lcd=yes addr=0x3F  row0=[RLux: 252.27    ]
---- LCD backpack at 0x27 ----
I2C scan: 0x27 0x29
LCD found at 0x27
----------------------------------
lcd=yes addr=0x27  row0=[RLux: 252.27 *  ]
---- LCD backpack at 0x00 ----
I2C scan: 0x29
WARN: no LCD backpack found on I2C (expected 0x27 or 0x3F).
----------------------------------
lcd=no addr=0x00  row0=[-]
---- plug the LCD (0x27) in after boot ----
LCD found at 0x27
lcd=yes addr=0x27 at t=11240 ms  row0=[RLux: 252.27 *  ]
