banpot/LightCheck-KM/calibration/sim/fig_cal_error.png

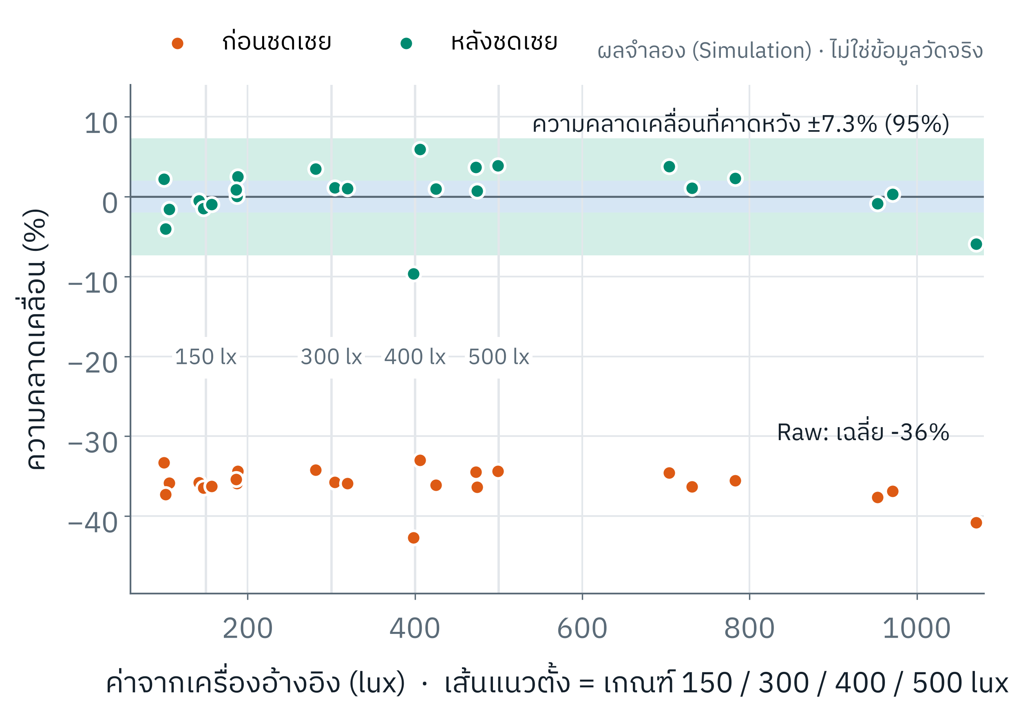
calibration/sim/fig_cal_error.png
