banpot/LightCheck-KM/calibration/sim/fig_decision.png

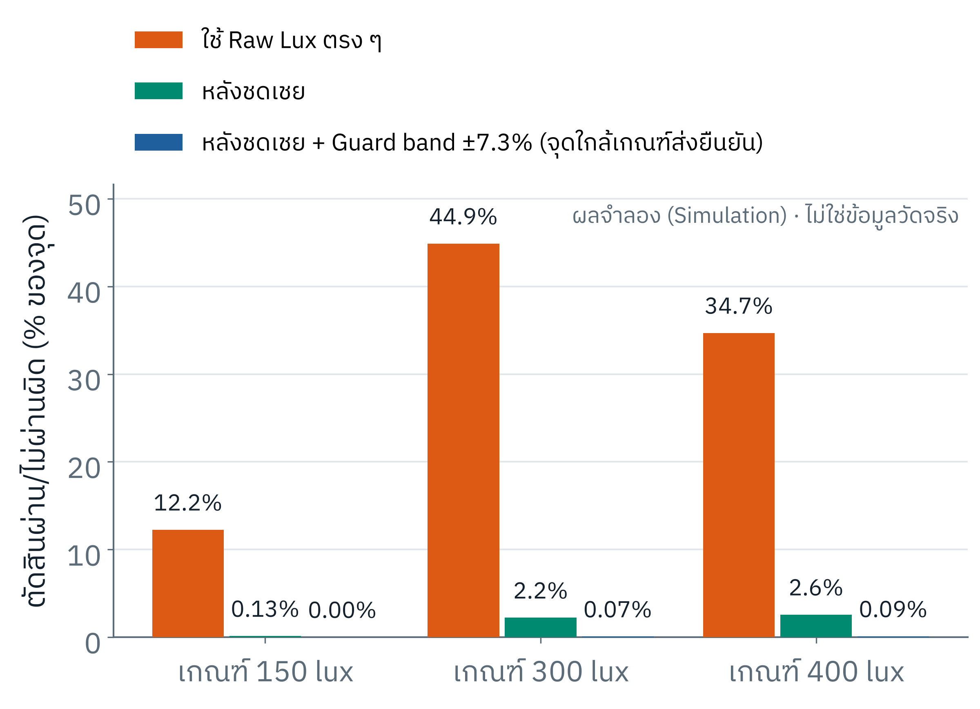
calibration/sim/fig_decision.png
