banpot/LightCheck-KM/calibration/sim/fig_mc_mape.png

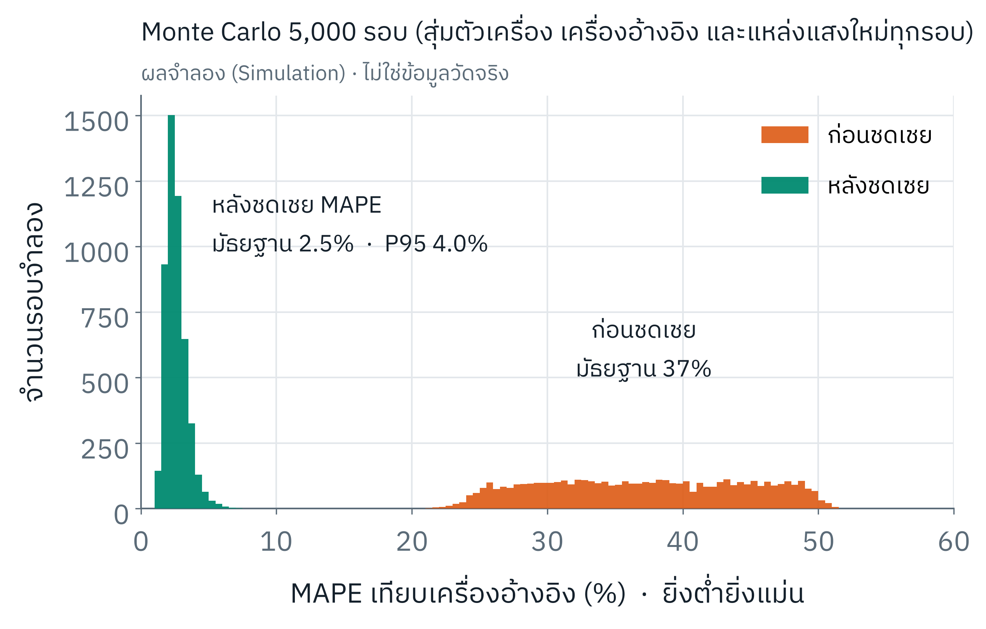
calibration/sim/fig_mc_mape.png
