banpot/LightCheck-KM/lessons-learned.md

# Lessons Learned

บันทึกบทเรียนที่ได้จากการพัฒนาและใช้งาน เพิ่มรายการใหม่ไว้ด้านบนสุด

## LL-05 · แสง LED ไม่เหมือนแสงธรรมชาติ และกะพริบตามไฟกระแสสลับ (ปัญหาที่พบหน้างาน)
ระหว่างลงพื้นที่พบว่าค่าที่อ่านได้ใต้โคม LED กระโดดไปมา และไม่สอดคล้องกับจุดที่มีแสงธรรมชาติผสม
- **สเปกตรัมต่างกัน**: LED มีพลังงานช่วงอินฟราเรดน้อย ส่วนแสงธรรมชาติมี IR สูง สูตร lux ของเซนเซอร์สองช่อง
  (Full − IR) จึงให้ความคลาดเคลื่อนต่างกันตามแหล่งแสง (datasheet: อัตราส่วน CH1/CH0 ของ LED ขาว 0.092–0.172)
- **การกะพริบ**: ไฟ LED กะพริบที่ 2 เท่าของความถี่ไฟฟ้า (ไฟบ้านไทย 50 Hz → 100 Hz, คาบ 10 ms)
  และบางโคมใช้ PWM dimming ทำให้ค่าแต่ละครั้งไม่นิ่ง
**วิธีแก้**: (1) ใช้ integration time ที่เป็นจำนวนเต็มเท่าของ 10 ms (300 ms = 30 รอบพอดี) เพื่อให้แต่ละค่ารวมรอบการกะพริบครบ
(2) firmware v1.1 เฉลี่ยค่า 5 รอบล่าสุดที่ gain เดียวกัน (rolling mean) และแสดง `*` บน LCD เมื่อ CV < 2 %
ผลทดสอบ `tools/fw_sim`: ค่าที่แสดงแกว่งลดลงราว 2.3 เท่า (เช่น 3.0 % → 1.5 %)
(3) สอบเทียบด้วยแหล่งแสงจริงของสำนักงาน และวัดช่วงแสงธรรมชาติน้อยที่สุดตาม SOP

## LL-04 · r² สูงไม่ได้แปลว่าแม่น (2569-10)
ผลจำลองให้ r² ≈ 0.996 ทั้งก่อนและหลังชดเชย ขณะที่ MAPE ก่อนชดเชยสูงถึง ~37 %
**บทเรียน**: รายงาน MAE / RMSE / MAPE / Max APE เสมอ และใช้ r² ดูความเป็นเส้นตรงเท่านั้น

## LL-03 · จุดใกล้เกณฑ์ต้องมีกติกาชัด (2569-10)
ความคลาดเคลื่อนของเครื่องต้นแบบทำให้ค่าที่อยู่ใกล้ 300 / 400 lux ตัดสินผิดได้
**บทเรียน**: ใช้ guard band = U95 จากรายงานสอบเทียบ ค่าที่อยู่ในช่วงต้องยืนยันด้วยเครื่องมาตรฐาน
(ผลจำลอง: การตัดสินผิดที่เกณฑ์ 300 lux ลดจาก 2.2 % เหลือ 0.07 % โดยส่งยืนยันราว 13 % ของจุด)

## LL-02 · Auto-range ต้องมี hysteresis (firmware v1.0 → v1.1)
v1.0 เพิ่ม gain เมื่อ counts < 1/16 ของ full scale โดยไม่คาดการณ์ค่าหลังเพิ่ม gain (x17–25)
จึงแกว่งระหว่าง gain และขึ้น SATURATED เป็นช่วง ๆ และอ่านค่าต่ำกว่า ~260 lux ด้วย gain สูง
ซึ่งเพิ่ม step ~5 % จาก gain จริงที่ไม่ตรงค่าที่ไลบรารีสมมติ
**บทเรียน**: ทดสอบ logic บนคอมพิวเตอร์ด้วยแบบจำลองเซนเซอร์ก่อน (`tools/fw_sim`) และตรึงช่วงแสงใช้งาน
ไว้ที่ gain เดียวเพื่อให้สมการชดเชยชุดเดียวใช้ได้ทั้งช่วง

## LL-01 · ตัวเลขทุกตัวต้องย้อนกลับไปที่ datasheet ได้
ค่า saturation ที่ 100 ms เดิมใช้ 37,888 แต่ datasheet ระบุ 36,863 counts
**บทเรียน**: อ้างอิง datasheet ใน comment ของโค้ดทุกค่าคงที่ และอย่าระบุ accuracy ±X % ของ TSL2591
เพราะ datasheet ไม่ได้ให้ค่า end-to-end lux accuracy
