banpot/LightCheck-KM/docs/open-problems.md

# ช่องว่างที่เปิดให้ร่วมพัฒนา (Open problems)

LightCheck KM ตั้งใจให้ความรู้เติบโตต่อจากผู้ใช้หลายส่วนงาน ไม่หยุดอยู่ที่ผู้พัฒนาคนแรก
หัวข้อด้านล่างเป็นช่องว่างที่ยังไม่มีใครทำ เลือกหัวข้อแล้วเปิด Issue ชื่อ `[ร่วมพัฒนา] ชื่อหัวข้อ`
เพื่อไม่ให้ทำซ้ำกัน จากนั้นส่ง Pull Request ได้เลย

| # | หัวข้อ | ทำไมสำคัญ | ทักษะที่ใช้ | ระดับ |
|---|---|---|---|---|
| 1 | **วัดคู่จริงกับเครื่องมาตรฐาน** อย่างน้อย 20 จุดต่อชนิดหลอด หลายห้อง หลายช่วงเวลา | แทนผลจำลอง Monte Carlo ด้วยข้อมูลจริง แล้วเผยแพร่สมการชดเชยและ U95 จริง | ตาม SOP, บันทึก CSV ใน `calibration/paired_measurements.csv` | ง่าย |
| 2 | **สมการชดเชยแยกตามชนิดแสง** (LED, ฟลูออเรสเซนต์, แสงธรรมชาติผสม) | สเปกตรัมต่างกันทำให้ bias ต่างกัน ใช้อัตราส่วน CH1/CH0 เลือกสมการอัตโนมัติ | Python, firmware C++ | กลาง |
| 3 | **Wi-Fi logging + dashboard** | ESP8266 มี Wi-Fi อยู่แล้ว ส่งค่า Raw/Corrected เข้าเซิร์ฟเวอร์ แล้วสร้างแบบบันทึก Green Office ได้เอง | Node.js + EJS, SQLite หรือ MongoDB, ESP8266 HTTP | กลาง |
| 4 | **ฝากระจายแสง (cosine diffuser)** เช่นแผ่น PTFE/อะคริลิกขุ่นบนหัวรับแสง | ลดความคลาดเคลื่อนเมื่อแสงเข้ามาเฉียง ให้ใกล้เครื่องมาตรฐานมากขึ้น | ออกแบบกล่อง (`hardware/enclosure/src`), ทดสอบมุม | กลาง |
| 5 | **แผนที่ความสว่าง (heatmap) จากกริด 2 × 2 ม.** | ผู้บริหารเห็นจุดมืดทั้งห้องในภาพเดียว และวางตำแหน่งโคมที่จะเพิ่มได้ | Python (`tools/survey/`) | ง่าย |
| 6 | **เซนเซอร์สภาพแวดล้อมเพิ่ม** CO₂ อุณหภูมิ ความชื้น เสียง บนบัส I²C เดียวกัน | ขยายเป็นสถานีตรวจสำนักงานสีเขียวในเครื่องเดียว | ฮาร์ดแวร์, firmware | กลาง |
| 7 | **PCB เล็กพร้อม I²C level shifter** (เช่น BSS138) | แก้ปัญหา pull-up 5 V ของ backpack LCD เมื่อสร้างหลายเครื่อง (ดู `docs/wiring.md`) | ออกแบบ PCB | กลาง |
| 8 | **ความแปรปรวนระหว่างเครื่อง** (unit-to-unit) | รู้ว่าต้องสอบเทียบทุกเครื่องหรือใช้สมการร่วมได้ | วัดซ้ำหลายเครื่อง, สถิติ | ง่าย |

## กติกาสั้น ๆ

- ทุกตัวเลขที่เพิ่มต้องย้อนกลับไปที่ข้อมูลหรือ datasheet ได้ (บทเรียน LL-01 ใน [`lessons-learned.md`](../lessons-learned.md))
- ข้อมูลภาคสนามให้ปิดบังข้อมูลส่วนบุคคลก่อนอัปโหลด
- เพิ่มบทเรียนใหม่ใน `lessons-learned.md` เมื่อเจอปัญหาหน้างาน เพื่อให้คนถัดไปไม่ต้องเจอซ้ำ
- โค้ดใช้สัญญาอนุญาต MIT เอกสารและฮาร์ดแวร์ใช้ CC BY 4.0 (ดู [`LICENSE`](../LICENSE))
