banpot/LightCheck-KM/(commit log)

2026-10-23 Fix auto-range gain hunting (firmware v1.1.0) and add host-side firmware simulation
    v1.0 stepped the gain up whenever Full < 4095 counts without predicting the
    counts at the next gain, so it oscillated between gains and printed SATURATED.
    v1.1 predicts next-gain counts, adds hysteresis, keeps office light on MED gain,
    adds CAL_GAIN/CAL_TIMING scope flag and optional CSV serial output.
    Claude-Session: https://claude.ai/code/session_0117EqVLPBj3ceK6FwdrTein
    [LightCheck_TSL2591_Calibrated.ino, autorange_test.cpp, v1.0_reference.ino]
2026-10-23 Add calibration toolkit and Monte Carlo accuracy simulation
    fit_calibration.py for real paired data, simulate_calibration.py (5,000
    simulated campaigns), expected_bias_from_datasheet.py, figures. All numbers
    are labelled SIMULATION until real paired measurements exist.
    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
    [paired_measurements.csv, representative_campaign.csv]
2026-10-23 Add parametric 3D-printable enclosure (STL, generator, renders)
    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
    [_lid_assembled.stl, d1_bottom.stl, d1_pcb.stl, d1_shield.stl, d1_usb.stl, lcd_backpack.stl, lcd_bezel.stl, lcd_glass.stl]
2026-10-23 Add wiring diagram, component illustrations and firmware flow
    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
2026-10-23 Add survey tools: 2x2 m grid planner, office digital twin and survey forms
    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
    [light-survey-form.csv, light-survey-form_example-8x6m.csv]
2026-10-23 Stabilise readings against LED flicker (rolling mean + stable flag)
    Field lesson: LED light is not like daylight (different spectrum/IR) and it
    flickers at 100 Hz on the 50 Hz grid, so single readings jump. Integration
    time 300 ms covers exactly 30 flicker periods; v1.1 now averages the last 5
    valid readings at one gain, logs CV/Stable and shows '*' on the LCD when the
    CV is below 2 %. Host test: displayed jitter reduced about 2.3x.
    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
    [LightCheck_TSL2591_Calibrated.ino, autorange_test.cpp, flicker_test.cpp]
2026-10-23 Add poster sources, poster figure variants and the compensation equation
    Poster (80x100 cm, KM Day 2569 template) is generated from the simulation
    outputs; calibration/README.md now spells out the full compensation chain
    (ADC -> raw lux -> 5-reading mean -> E = a*E_raw + b, OLS for a and b).
    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
2026-10-23 Real component costs (≈385 THB), filament estimate by expected weight, poster update
    - hardware/bom.md: MCU 89 + sensor 200 + LCD 70 THB + PLA+ at 480 THB/kg
    - hardware/enclosure/src/estimate_filament.py: layer-sliced shell/infill model
    -> ~54 g (~26 THB); total ~385 THB, ~68x cheaper than Hioki FT3424
    - evidence: enclosure printing on Creality Ender-6
    - poster: real photos (CC BY-SA), larger QR with 5-step how-to-use, logo sizes
    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
2026-10-23 Real survey results, lamp upgrade calculator, USB-C power source, editable poster source
    - README + docs/lighting-improvement.md: real screening result (almost every BDT
    office except meeting rooms 10-30 % below standard) and the management plan
    (small deficit -> higher-watt LED, large deficit -> more lamps) with lumen-method formulas
    - tools/survey/lighting_upgrade.py: P_new / N_new calculator with U95 margin
    - Wiring diagram: USB-C 5 V supply from a power bank; D1 mini drawn with USB-C;
    diagram generators published in tools/diagrams/
    - poster/: editable 80 x 100 cm PowerPoint source (native text boxes, shapes, KM cycle),
    HTML -> PPTX converter, PDF -> CMYK converter for files expor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
2026-10-23 Poster: worker-health harms, LED 50 Hz -> 100 Hz flicker lesson, open problems; no orphan lines
    - Introduction: effects of insufficient light on workers (HSE HSG38, CCOHS) and why the indicator exists
    - Methods: field lesson box - LED brightness follows current magnitude, so 50 Hz mains gives
    100 flashes/s (DOE/PNNL 2016); 300 ms integration = 30 cycles + rolling mean of 5
    - Results: "open for contribution on GitHub" box; docs/open-problems.md lists the gaps
    - Copy edited so no paragraph ends with a lone word; pptx/lines.js reports line fill,
    pptx/lo_lines.py checks the LibreOffice render of the PowerPoint source
    Claude-Session: ht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
2026-10-23 Oral presentation deck for Silpakorn KM Day 2569
    17 main slides + 4 Q&A backup slides with Thai speaker notes and explicit references:
    worker health first, why the indicator exists, "enough or not" decision with guard band,
    PDCA + KM cycle, prototype cost, USB-C power bank wiring, LED 50 Hz -> 100 Hz flicker lesson,
    compensation equation, simulated accuracy, real screening result and lamp-upgrade formulas,
    benefits for faculties vs technical staff, dissemination, open problems for contributors.
    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
2026-10-23 Proofreading: Royal Institute spelling (กะพริบ, นอต), clearer simulated vs real labels
    - Deck: slide 12 titled as a real screening result; simulated figures labelled on slides 5 and 9;
    "fail" zone now says plan improvement (confirm before purchase); Wi-Fi dashboard marked as a concept;
    compensation needs a calibrated unit; LER wording; formal Thai phrasing
    - Poster and docs: กะพริบ / นอต spelling; dissemination doc scopes "make all" to simulated numbers
    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
2026-10-27 Enclosure 1.1: printer-tolerant screw holes, loose fit profile, hole fit test
    - Holes printed too tight to drive screws: M3 pilot 2.5 -> 2.8 mm, M2.5 pilot 2.1 -> 2.3 mm,
    M3 clearance/counterbore, 1/4"-20 nut pocket and tripod hole +0.2 mm, 45-degree lead-in on
    every pilot, corner bosses 7.0 -> 7.6 mm
    - stl/loose/ for coarse printers (holes +0.4 mm, 0.55 mm clearance); --fit custom for any printer
    - stl/fit_test/hole_fit_test.stl (~10 g) with labelled M3 / M2.5 pilots and nut pockets
    - Both profiles watertight, no interference with module proxies, sensor plane unchanged
    Claude-Session: https://claude.ai/code/session_0117EqVLPBj3ceK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
    [_lid_assembled.stl, d1_bottom.stl, d1_pcb.stl, d1_shield.stl, d1_usb.stl, hole_fit_test.stl, lightcheck_base.stl, lightcheck_base_loose.stl]
2026-10-28 Firmware 1.1.1: auto-detect the LCD address, I2C scan, Serial-only fallback
    The LCD stayed blank with PCF8574T backpacks (0x27) because v1.1.0 used a
    fixed 0x3F address. The address is now auto-detected (0x27, 0x3F, then the
    PCF8574/PCF8574A ranges), the boot log prints an I2C scan, and the meter keeps
    measuring on Serial when no LCD answers, retrying the LCD every 5 s.
    Measurement logic unchanged: tools/fw_sim results identical; new boot test.
    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
    [LightCheck_TSL2591_Calibrated.ino, autorange_test.cpp, boot_test.cpp, flicker_test.cpp]
2026-10-28 Poster and deck: real photos of the assembled meter and the lid printing
    - Poster figure 5: photo of the assembled LightCheck KM (replaces the placeholder)
    - Poster figure 4 and deck slide 8: new Ender-6 print photo matching the final colours
    - Repository stats on the poster and deck updated (20 docs, 5 STL, 20 Python tools)
    - evidence/2026-10_prototype/ with the original photos
    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
